drivkin/Autobalance/hardware/Orders/PR_McMaster_Autobalancer_DR.xlsx

Sheet: PR
Purchase Request
 | ALL FIELDS are required to be filled in except for shaded areas prior to placing order.
 | Supplier Info |  |  |  |  | Project / Task # |  | Other |  |  | Category Codes: | Unit Size Codes: | Project/Task # | WBS | Order Method | Deliver To | Ship to Address
 |  |  |  |  |  | Other (Comments) |  | G-NAT T&I Labs |  |  | 39 | BX | MDD | 1-Project Mgmt | Phone/POC | Andrea Nazzal | NASA Ames Bld 202 Room 108 Moffett Field, CA 94035-1000
 | Name | McMaster Carr |  |  |  | WBS |  |  |  |  | 51 | CNT | MisST | 2-System Engineering | Web | Michael Henchke | NASA Ames Bld 240 Room 161 Moffett Field, CA 94035-1000
 | Contact |  |  |  |  | Requester Name |  | Dayne Kemp |  |  | 53 | CRT | EcAMSAT | 3-Safety and Mission Assurance | Email
 | Phone | 562-692-5911 |  |  |  | Phone # |  | (650) 604-4259 |  |  | 59 | CS | SporeSat | 4-Science and Technology | Fax
 | Address |  |  |  |  | Date Orignated |  | 2015-08-23 |  |  | 61 | DZ | NLAS | 5-Payload
 |  |  |  |  |  | Date Required |  | 2015-08-26 |  |  | 66 | EA | SPHERES | 6-Spacecraft
 | E-mail |  |  |  |  | Deliver To |  | Andrea Nazzal |  |  | 68 | FT | PhoneSat 1 | 7-Mission Ops
 | Web Link | www.mcmaster.com |  |  |  | Ship To Address |  | NASA Ames Bld 202 Room 108 Moffett Field, CA 94035-1000 |  |  | 75 | LOT | PhoneSat 2 | 8-Launch
 |  |  |  |  |  |  |  |  |  |  | 76 | OZA | WinkLink | 9-Ground Ops
 | Order Method | Web |  |  |  |  |  |  |  |  | 93 | PAK | UV-LED | 10-Integration and Test
 | Quote Number: | Web |  |  |  |  |  |  |  |  | 99 | RL | Lightforce | 11-EPO
 | Due Diligence (list of other Vendors Contacted): |  |  |  |  |  |  |  |  |  | 7020 | RM | OCT | Other
 |  |  |  |  |  |  |  |  |  |  | 7045 | RO | Franklin
 |  |  |  |  |  |  |  |  |  |  | J | SH | Edison
 |  |  |  | Please check where applicable |  |  |  |  |  |  | V1 | TU | TechEdSat
 |  |  |  | ____ | Material Safety Data Sheet |  |  |  |  |  |  |  | GraviSat
 |  |  |  | ____ | Certificate of Conformance |  |  |  |  |  |  |  | Proposals
 |  |  |  |  |  |  |  |  |  |  |  |  | MoonExpress
 | Category Codes: |  |  |  |  |  |  |  | Unit Size Codes: |  |  |  | EtherSat
 | 39 = Materials Handling Equipment |  |  | 75 = Office Supplies and Devices |  |  |  |  | BX = Box | OZA = Fluid Oz |  |  | SkyBox
 | 51 = Hand Tools |  |  | 76 = Books |  |  |  |  | CNT = Container | PAK = Pack |  |  | Ride the Light
 | 53 = Hardware & Adhesives |  |  | 93 = Nonmetallic Fabricated Materials |  |  |  |  | CRT = Carton | RL = Reel |  |  | NanoLab
 | 59 = Electronic Equipment & Components |  |  | 99 = Miscellaneous |  |  |  |  | CS = CASE | RM = Ream |  |  | Lab Upgrades
 | 61 = Electric Wire, Power & Distribution Equipment |  |  | J = Maintenance, Repair and Rebuilding of Equipment |  |  |  |  | DZ = Dozen | RO = Roll |  |  | Other
 | 66 = Instruments and Laboratory Equipment |  |  | V1=Transportation of Things |  |  |  |  | EA = Each | SH = Sheet
 | 7020= IT Purchases Gov't |  |  |  |  |  |  |  | FT = Feet | TU = Tube
 | 7045 = IT Supplies & Materials |  |  |  |  |  |  |  | LOT= Lot
 | Part Number |  | Item Description |  |  | Category | Unit Size | Quantity | Est. Price | Est. Extended Price
1 | 90322A657 (http://www.mcmaster.com/) |  | Grade 8 Steel Fully Threaded Rod, 1/4"-20 Thread, 2 Feet Long |  |  | 53 | EA | 2 | $6.93 | $13.86
2 | 94612A101 (http://www.mcmaster.com/) |  | Zinc Plated Grade 8 Steel Flange Nut, 1/4"-20 Thread Size, 19/32" Flange Diameter, 15/64" Overall Height , packs of 100 |  |  | 53 | BX | 1 | 7.48 | $7.48
3 | 90272A115 (http://www.mcmaster.com/) |  | Zinc-Plated Steel Pan Head Phillips Machine Screw, 4-40 Thread, 1" Length, packs of 100 |  |  | 53 | BX | 1 | $3.00 | $3.00
4 | 90272A121 (http://www.mcmaster.com/) |  | Zinc-Plated Steel Pan Head Phillips Machine Screw, 4-40 Thread, 2" Length, packs of 50 |  |  | 53 | BX | 1 | $6.30 | $6.30
5 | 90257A005 (http://www.mcmaster.com/) |  | Type 316 Stainless Steel Hex Nut, 4-40 Thread Size, 1/4" Wide, 3/32" High, packs of 100 |  |  | 53 | BX | 1 | $5.91 | $5.91
6 | 4416T91 (http://www.mcmaster.com/) |  | Very Easy-to-Machine 1215 Carbon Steel, Rod, 3/16" Diameter, 6' Length |  |  | 53 | EA | 1 | $5.89 | $5.89
7 |  |  |  |  |  |  |  |  |  | $0.00
8 |  |  |  |  |  |  |  |  |  | $0.00
9 |  |  |  |  |  |  |  |  |  | $0.00
10 |  |  |  |  |  |  |  |  |  | $0.00
11 |  |  |  |  |  |  |  |  |  | $0.00
12 |  |  |  |  |  |  |  |  |  | $0.00
13 |  |  |  |  |  |  |  |  |  | $0.00
14 |  |  |  |  |  |  |  |  |  | $0.00
15 |  |  |  |  |  |  |  |  |  | $0.00
16 |  |  |  |  |  |  |  |  |  | $0.00
17 |  |  |  |  |  |  |  |  |  | $0.00
18 |  |  |  |  |  |  |  |  |  | $0.00
19 |  |  |  |  |  |  |  |  |  | $0.00
20 |  |  |  |  |  |  |  |  |  | $0.00
 |  |  |  |  |  |  |  |  | Subtotal | $42.44
 |  | Dayne Kemp |  |  |  |  |  |  | Ship & Hand. | $15.00
 |  | Requester Signature |  |  |  |  |  |  | TAX | $15.80
 |  |  |  |  |  |  |  |  | Est. Total | $73.24
 |  | Authorizing Signature: Project Mangr or Task Lead

Sheet: Process
New NMO PR Process:
1- Individual generates PR (Save document
2- PR is submitted to WBS Lead or Project Manager (if no lead is assigned) for approval
3- Lead sends directly to Andrea Nazzal AND cc’s:
a. Elwood Agasid
b. PR Originator
c. Mike Henschke (SSPT only)
4- Andrea Nazzal verifies funding and sends to Dionna Marshall to place order
5- Dionna Marshall places order and sends email notification of when the package is expected to arrive to:
a. Lead who submitted the PR
b. PR Originator
c. Mike Henschke (SSPT only)
6- Mike Henschke (SSPT) or Dionna Marshall (MDD) will notify when the product has arrived
7- All original shipping documentation (invoices and packaging slips) MUST be turned into Dionna Marshall ASAP
PR Originator is responsible for the following:
1- Making sure PR is filled completely and accurately
2- Knowing lead times associated with the order and notating on PR
3- Noting back ordered items when possible
4- Not designating ASAP, provide hard date
5- Be cognicent of overnight shipping it REALLY eats away at your budget
Program or Project Leads
EcAMSat (MoO1) | Karolyn Ronzano
Ethersat | Belgacem Jaroux
Gravisat | Tony Ricco
Lightforce | Belgacem Jaroux/ Creon Levit
MDD | Belgacem Jaroux
MisST | Andres Martinez
NanoLab (ISSRP) | Macarena Parra/Andres Martinez
NLAS | Andres Martinez
Phonesat | Belgacem Jaroux
Spheres | Andres Martinez
Sporesat (MoO2) | Ron Chinnapongse
UVLED | John Hanson/Belgacem Jaroux
