drivkin/Autobalance/hardware/Orders/McMasterJuly13.xlsx

Description | McMaster Part number | Quantity | Notes
Angle Brackets | 1556A26 | 10
Shoulder screws 4-40, 1/8” shoulder | 91259A154 | 25
Ball bearing | 6383K213 (http://www.mcmaster.com/) |  | talk to machinist about putting in ¼ threaded lead screw
3/8” rod | 89535K87 (http://www.mcmaster.com/) | 6ft
Brass bars (1x2x6)” |  | 1 | not ordered
flanged sleeve bearings | 9440T17 | 12
