drivkin/Autobalance/hardware/Orders/first order.xlsx

Part | Manufacturer | Quantity | part number | other param | quote | Contact
Lead screw | Helix Linear | 3 |  | 1/4" diameter, .024" lead, 1 foot length | about $180 total screws and nuts | Keith Bell, +1 216 485-2309, kbell@helixlinear.com
Anti-backlash nut | Helix Linear | 3 | AFA025024R | high force spring, flanged |  | ditto
Stepper Motor | Lin Engineering | 3 | 3709Z-12 | Mounting option 4 | 63.81 each | Monica in customer service, 408-919-0200
