drivkin/Autobalance/CAD/first time mockup/whole_assembly.SLDASM

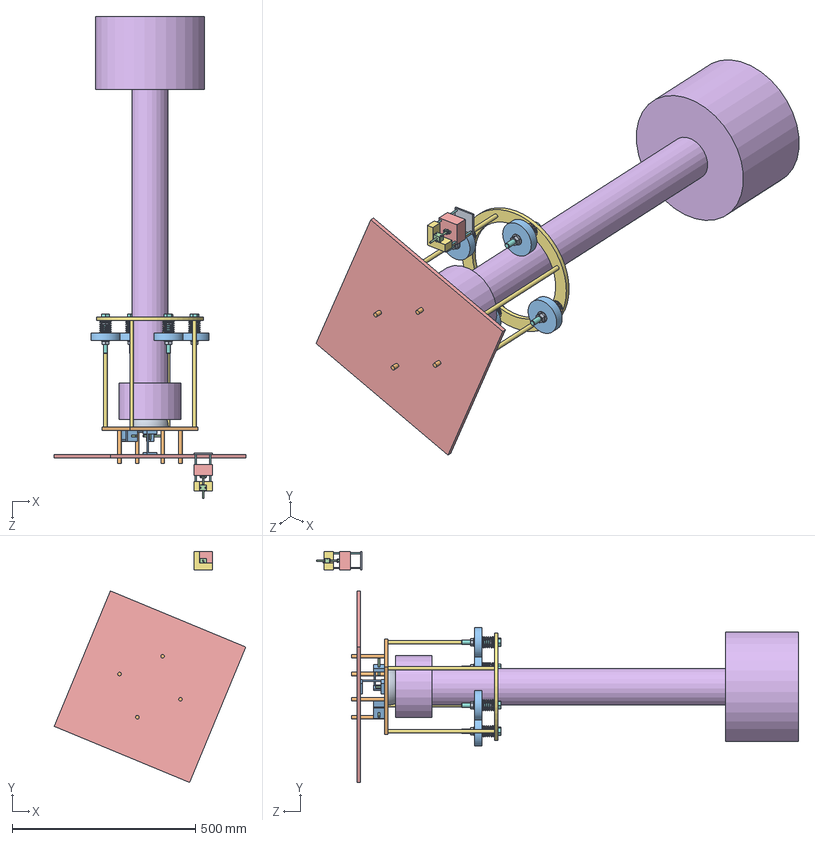
[picture p8: CAD file, 2015-06-24]
CAD/first time mockup/whole_assembly.SLDASM
522.7 x 630.1 x 1315.9 mm
bearing
balance_base
motor_body x 3
motor_shaft x 3
testbed
pedestal
manual_balance_rim
B18.2.3.6M - Heavy hex bolt M12 x 1.75 x 100 --100C x 4
B18.2.2.4M - Hex flange nut, M12 x 1.75 --N x 8
spring x 4
BIGweight x 4
N-422_50
weight
B18.6.7M - M2 x 0.4 x 20 Indented HHMS --20C x 4
base
supportRod x 2
endPiece
