drivkin/Autobalance/CAD/force sensor calibrator/side.SLDPRT

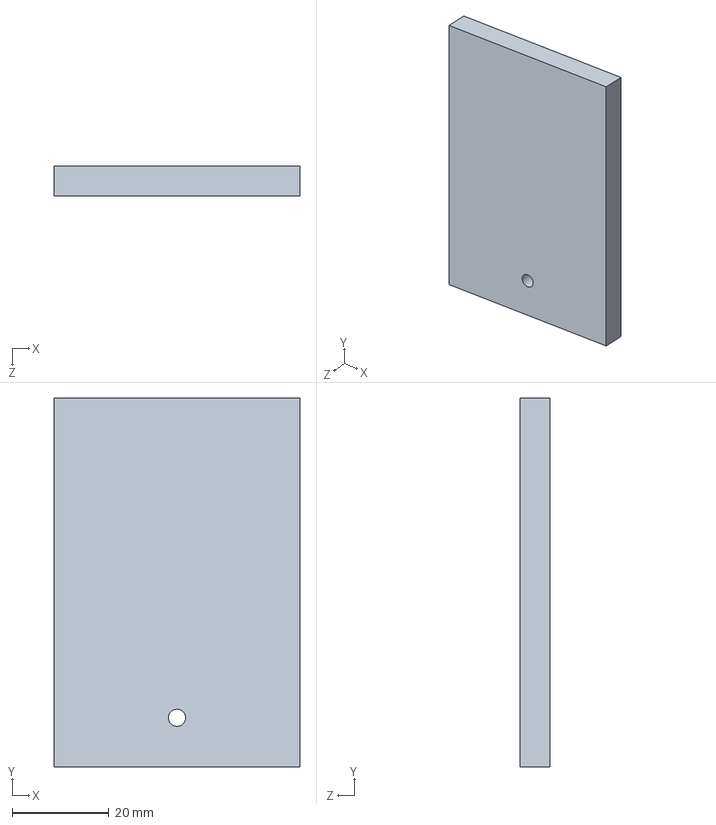
[picture p9: CAD file, 2015-09-15]
CAD/force sensor calibrator/side.SLDPRT
50.8 x 76.2 x 6.10 mm
