drivkin/Autobalance/CAD/TestBed Alternate/level.SLDPRT

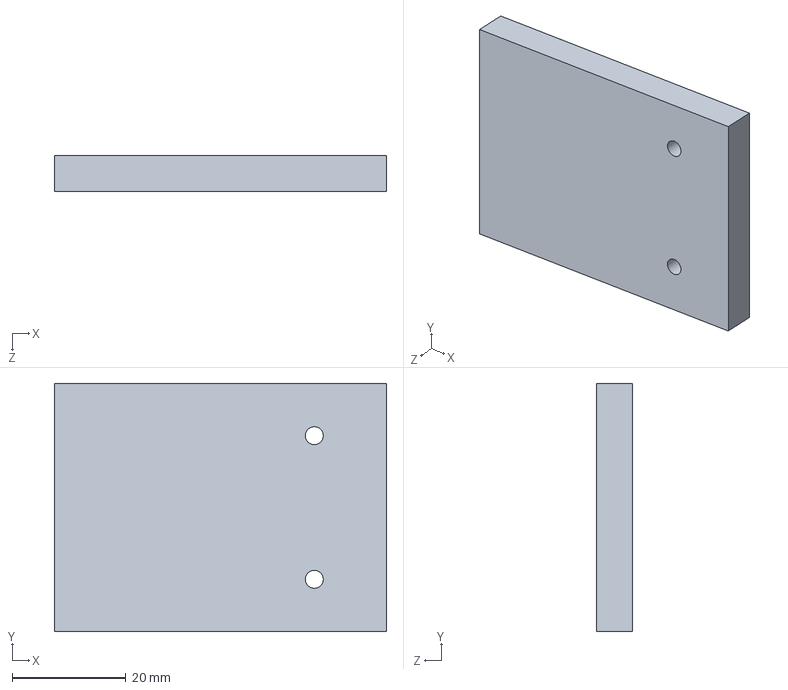
[picture p10: CAD file, 2015-09-15]
CAD/TestBed Alternate/level.SLDPRT
58.4 x 43.7 x 6.35 mm
