drivkin/Autobalance/CAD/TestBed/ABpedestal.SLDPRT

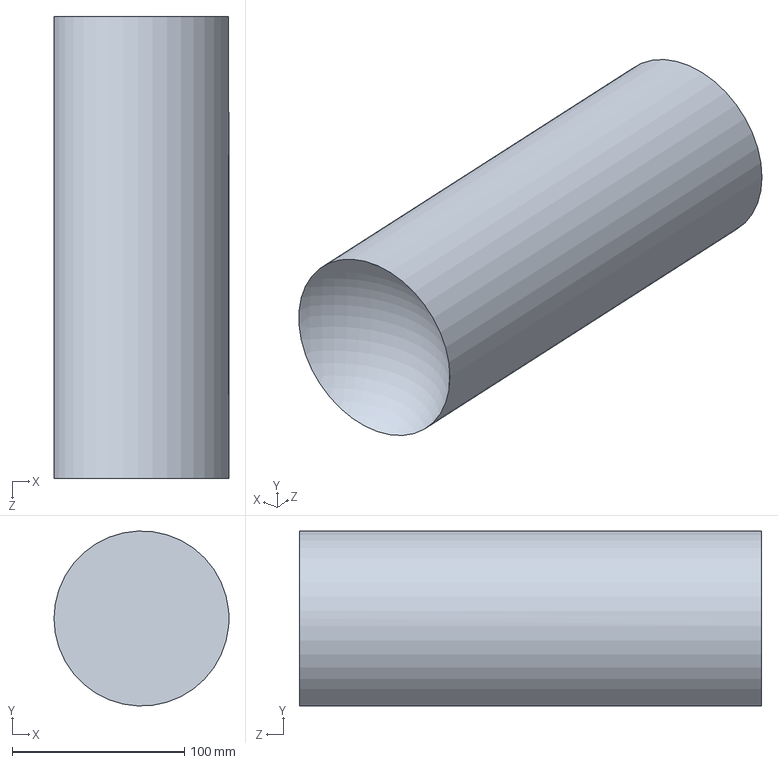
[picture p11: CAD file, 2015-07-17]
CAD/TestBed/ABpedestal.SLDPRT
101.6 x 101.5 x 268.4 mm
