drivkin/Autobalance/CAD/first time mockup/driver.SLDPRT

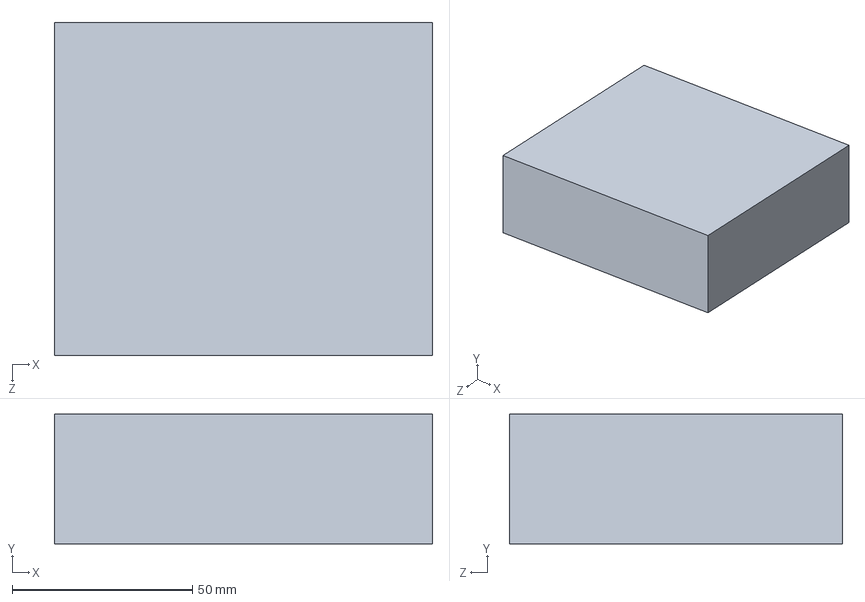
[picture p12: CAD file, 2015-06-24]
CAD/first time mockup/driver.SLDPRT
105.0 x 36.0 x 92.5 mm
