drivkin/Autobalance/CAD/FSR/lip_support.SLDPRT

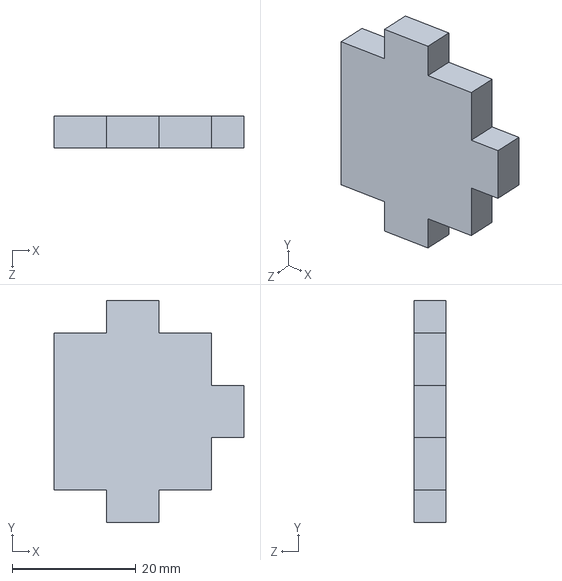
[picture p13: CAD file, 2015-09-15]
CAD/FSR/lip_support.SLDPRT
30.6 x 35.8 x 5.21 mm
