drivkin/Autobalance/CAD/N-422_50 assembly/weight.SLDPRT

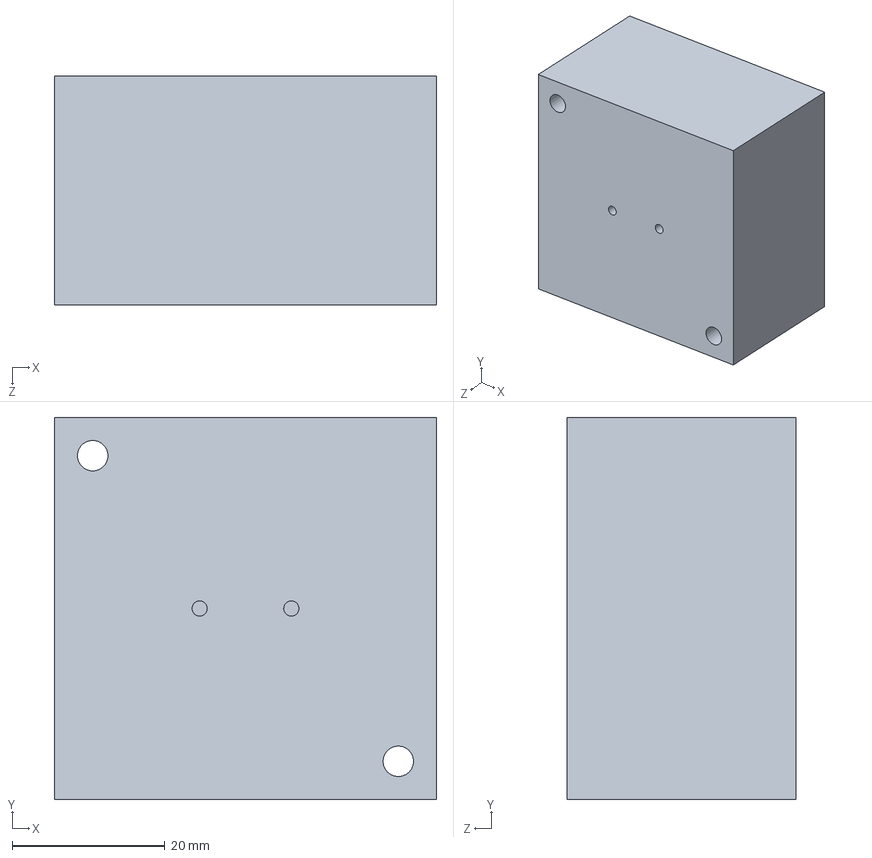
[picture p14: CAD file, 2015-07-06]
CAD/N-422_50 assembly/weight.SLDPRT
50.0 x 50.0 x 30.0 mm
