drivkin/Autobalance/CAD/TestBed Alternate/alt_AD_Testbed_Top.SLDPRT

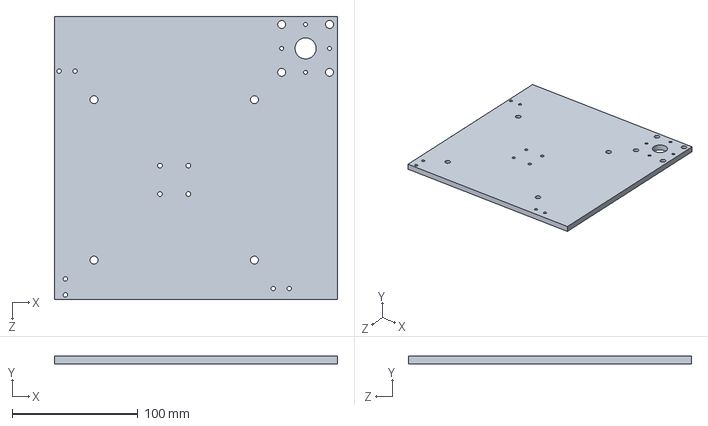
[picture p15: CAD file, 2015-09-15]
CAD/TestBed Alternate/alt_AD_Testbed_Top.SLDPRT
225.2 x 6.35 x 225.2 mm
