drivkin/Autobalance/CAD/force sensor calibrator/arm.SLDPRT

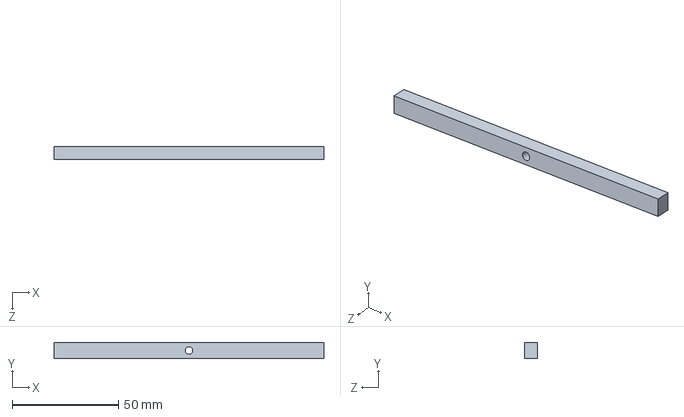
[picture p16: CAD file, 2015-09-15]
CAD/force sensor calibrator/arm.SLDPRT
127.0 x 7.62 x 6.10 mm
