drivkin/Autobalance/CAD/FSR/vert_slider_lip.SLDPRT

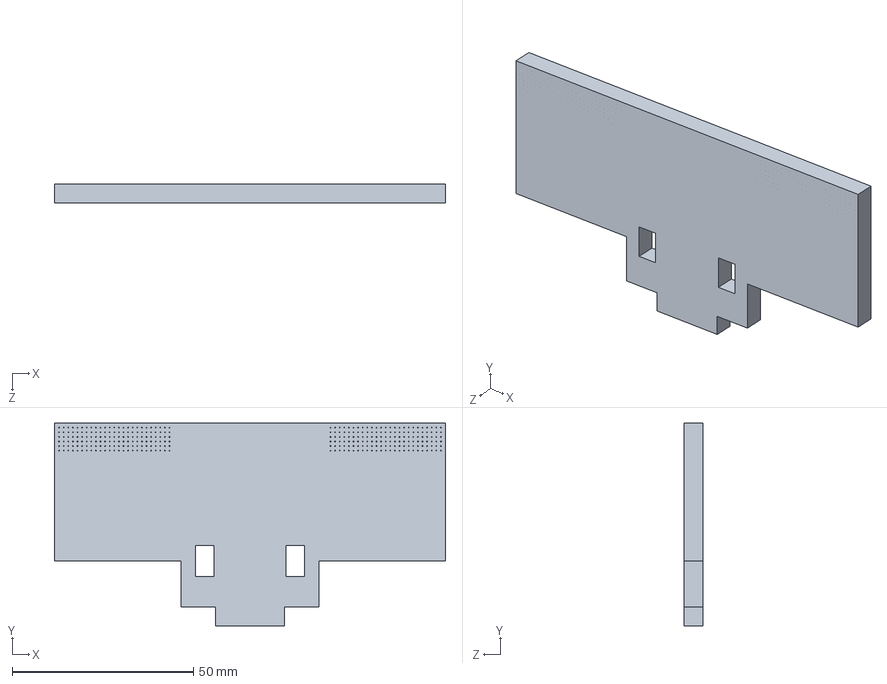
[picture p17: CAD file, 2015-09-15]
CAD/FSR/vert_slider_lip.SLDPRT
108.0 x 56.0 x 5.21 mm
