drivkin/Autobalance/CAD/N-422_50 assembly/base.SLDPRT

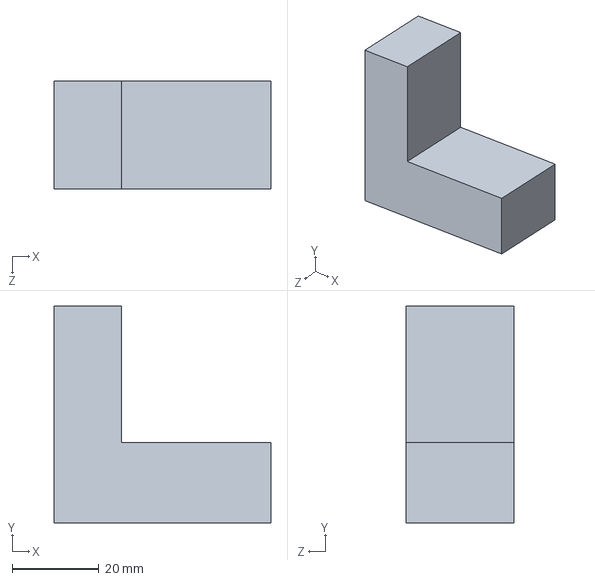
[picture p18: CAD file, 2015-06-24]
CAD/N-422_50 assembly/base.SLDPRT
50.0 x 50.0 x 25.0 mm
