drivkin/Autobalance/CAD/TestBed Alternate/alt_basement.SLDPRT

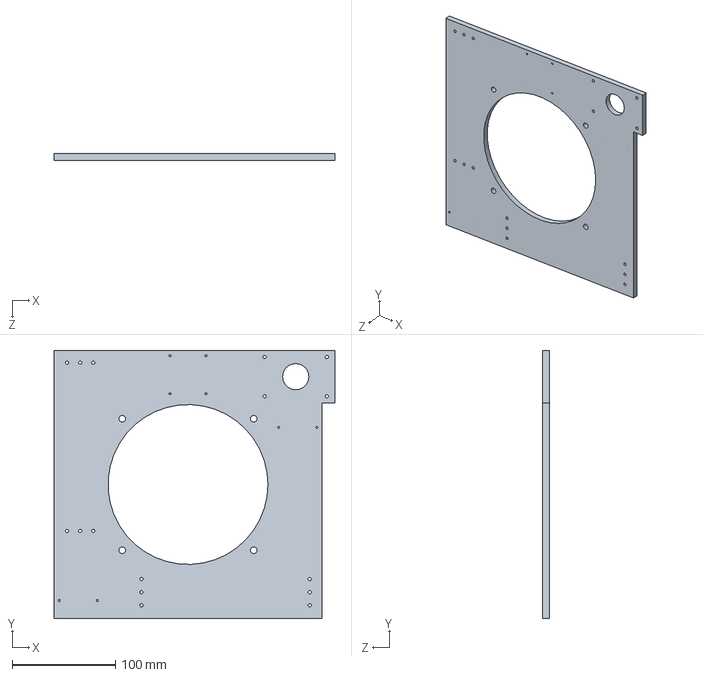
[picture p19: CAD file, 2015-09-15]
CAD/TestBed Alternate/alt_basement.SLDPRT
272.7 x 260.1 x 6.35 mm
