drivkin/Autobalance/CAD/TestBed/ABsphere.SLDPRT

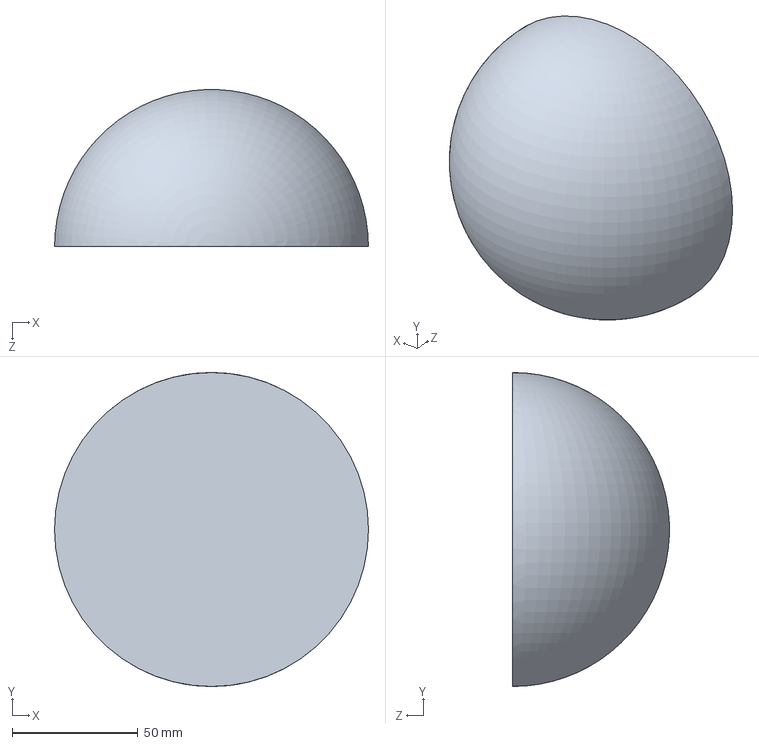
[picture p20: CAD file, 2015-07-17]
CAD/TestBed/ABsphere.SLDPRT
125.0 x 125.0 x 62.4 mm
