drivkin/Autobalance/CAD/first time mockup/BIGweight.SLDPRT

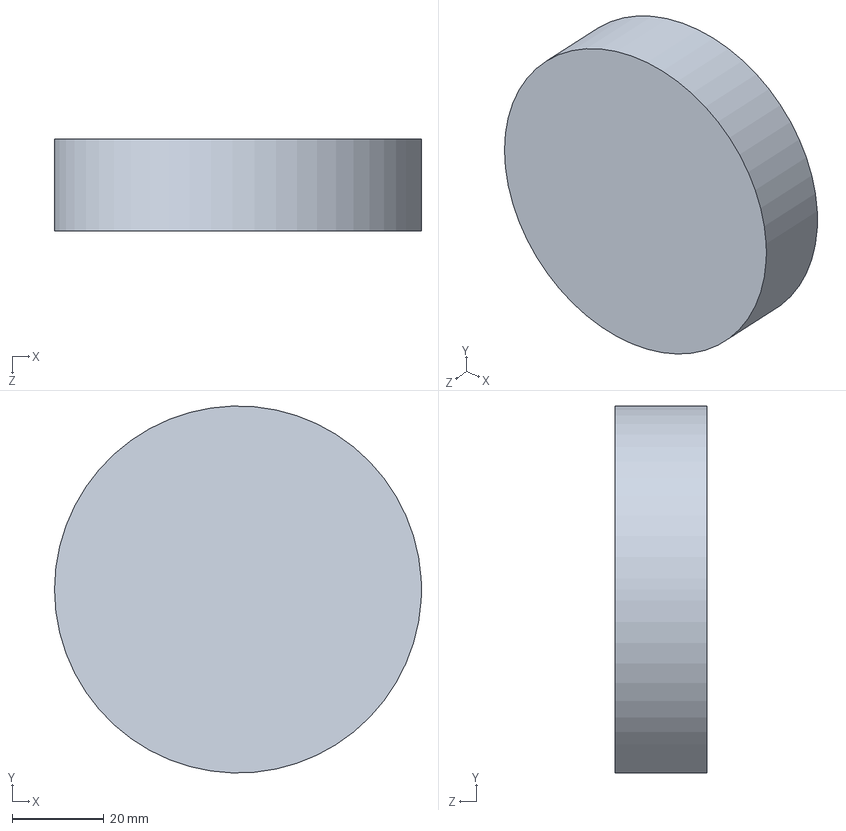
[picture p21: CAD file, 2015-06-18]
CAD/first time mockup/BIGweight.SLDPRT
80.0 x 80.0 x 20.0 mm
