drivkin/Autobalance/CAD/force sensor calibrator/connector.SLDPRT

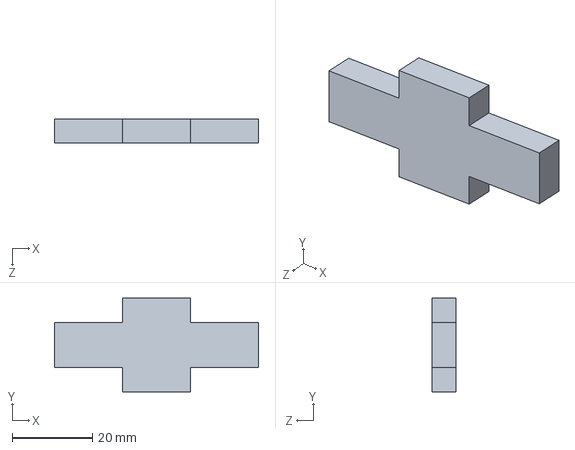
[picture p22: CAD file, 2015-09-15]
CAD/force sensor calibrator/connector.SLDPRT
50.8 x 23.4 x 6.10 mm
