drivkin/Autobalance/CAD/FSR/vert_slider.SLDPRT

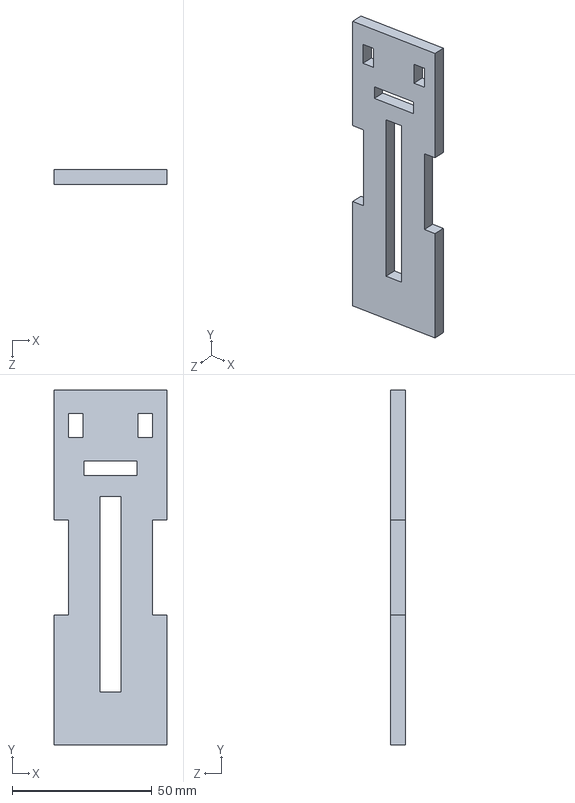
[picture p23: CAD file, 2015-09-15]
CAD/FSR/vert_slider.SLDPRT
40.4 x 127.0 x 5.21 mm
