drivkin/Autobalance/CAD/N-422_50 assembly/endPiece.SLDPRT

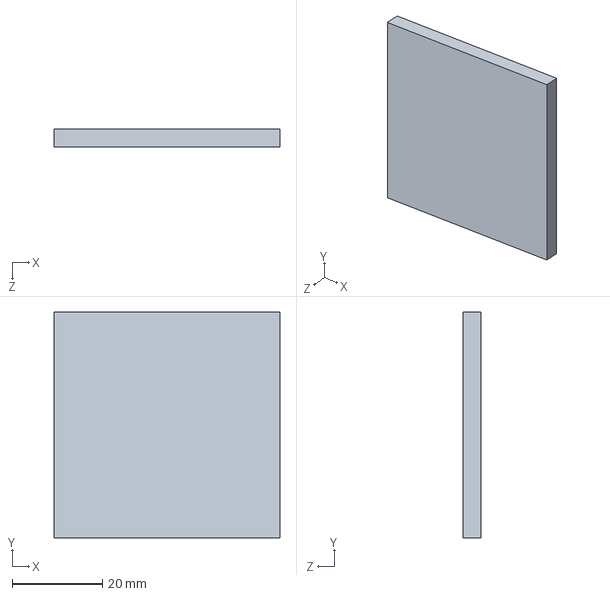
[picture p24: CAD file, 2015-06-24]
CAD/N-422_50 assembly/endPiece.SLDPRT
50.0 x 50.0 x 4.00 mm
