drivkin/Autobalance/CAD/TestBed/AD_Testbed_Bottom_LEDholes.SLDPRT

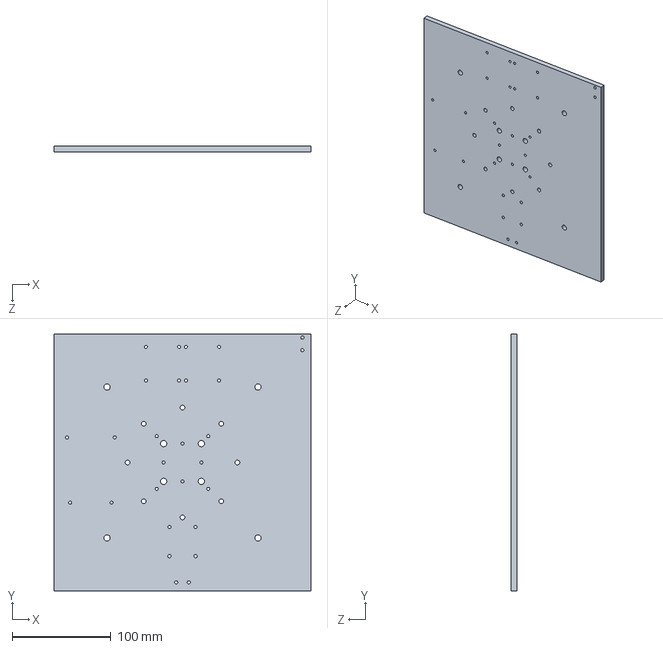
[picture p26: CAD file, 2015-07-17]
CAD/TestBed/AD_Testbed_Bottom_LEDholes.SLDPRT
260.0 x 260.0 x 6.35 mm
