drivkin/Autobalance/CAD/first time mockup/B18.2.2.4M - Hex flange nut, M12 x 1.75 --N.SLDPRT

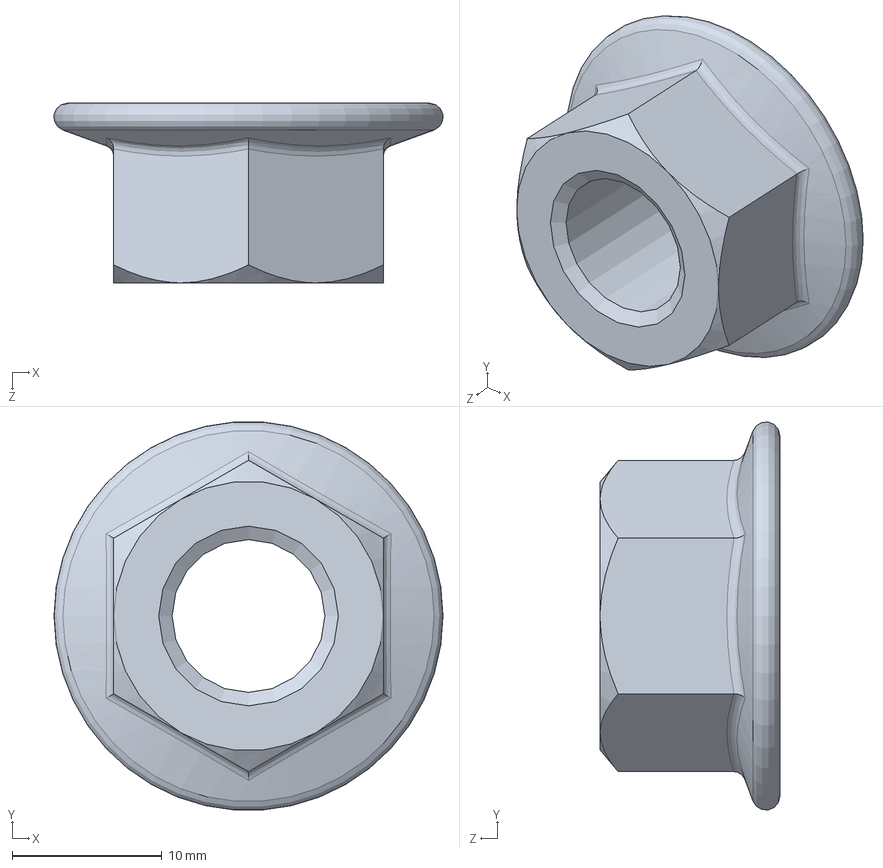
[picture p27: CAD file, 2015-06-18]
CAD/first time mockup/B18.2.2.4M - Hex flange nut, M12 x 1.75 --N.SLDPRT
26.0 x 25.9 x 12.0 mm
