drivkin/Autobalance/CAD/FSR/vert_slider_side.SLDPRT

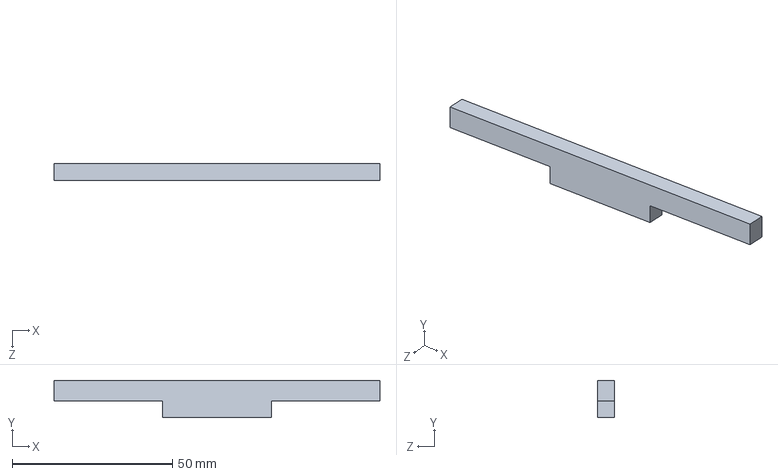
[picture p28: CAD file, 2015-09-15]
CAD/FSR/vert_slider_side.SLDPRT
101.6 x 11.6 x 5.21 mm
