drivkin/Autobalance/CAD/N-422_50 assembly/N-422_50.SLDPRT

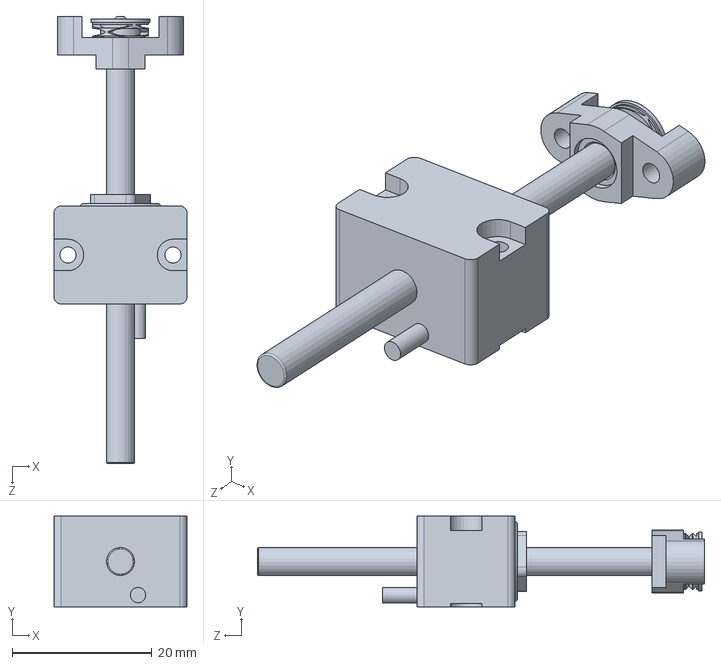
[picture p29: CAD file, 2015-06-24]
CAD/N-422_50 assembly/N-422_50.SLDPRT
19.0 x 13.0 x 63.9 mm
