drivkin/Autobalance/CAD/TestBed/third_floor.SLDPRT

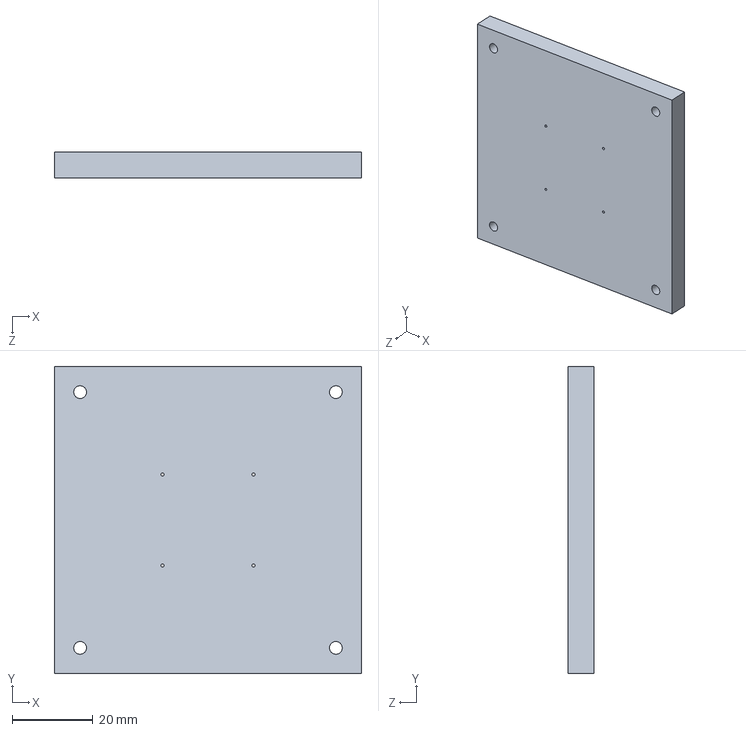
[picture p30: CAD file, 2015-07-16]
CAD/TestBed/third_floor.SLDPRT
76.2 x 76.2 x 6.35 mm
