drivkin/Autobalance/CAD/first time mockup/bearing.SLDPRT

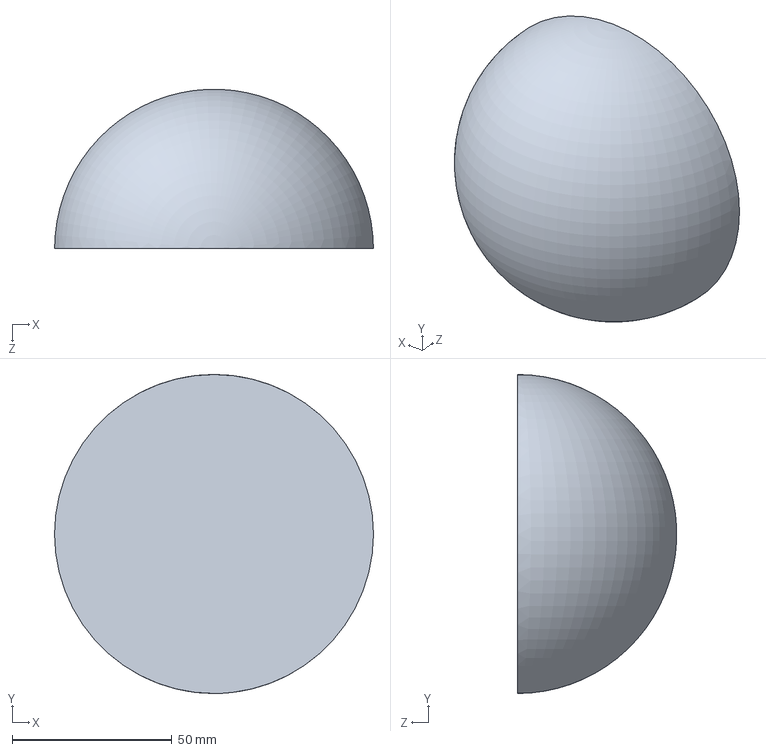
[picture p31: CAD file, 2015-06-18]
CAD/first time mockup/bearing.SLDPRT
100.0 x 100.0 x 49.9 mm
