drivkin/Autobalance/CAD/FSR/vert_slider_base.SLDPRT

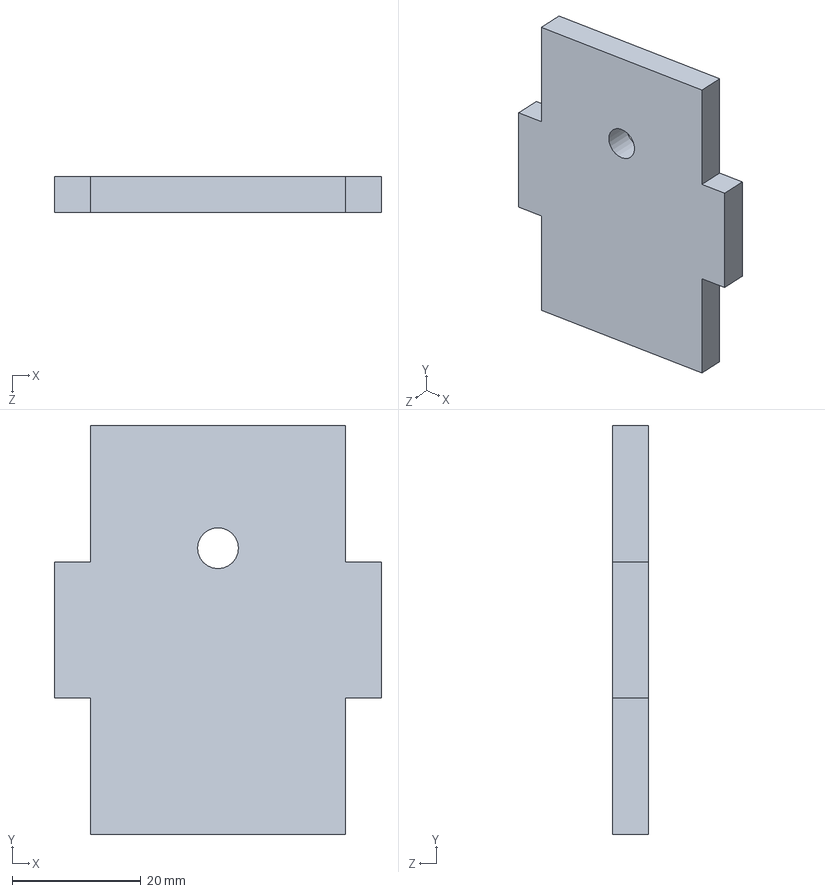
[picture p32: CAD file, 2015-09-15]
CAD/FSR/vert_slider_base.SLDPRT
50.8 x 63.5 x 5.59 mm
