drivkin/Autobalance/CAD/N-422_50 assembly/B18.6.7M - M2 x 0.4 x 20 Indented HHMS --20C.sldprt

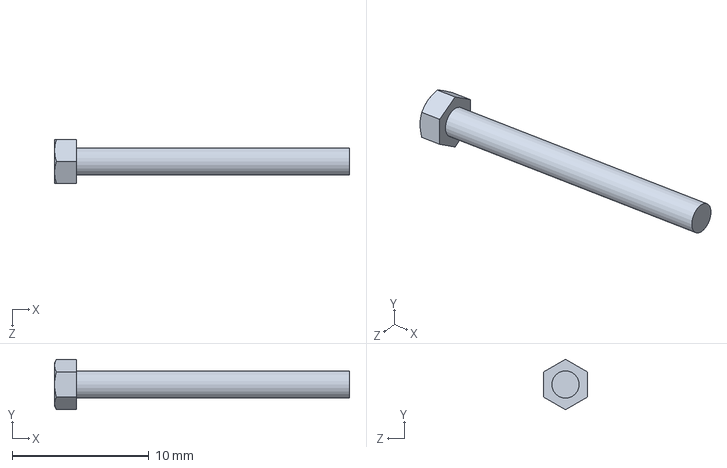
[picture p33: CAD file, 2015-06-24]
CAD/N-422_50 assembly/B18.6.7M - M2 x 0.4 x 20 Indented HHMS --20C.sldprt
21.6 x 3.70 x 3.20 mm
