drivkin/Autobalance/CAD/TestBed Alternate/alt_food_crate_storage.SLDPRT

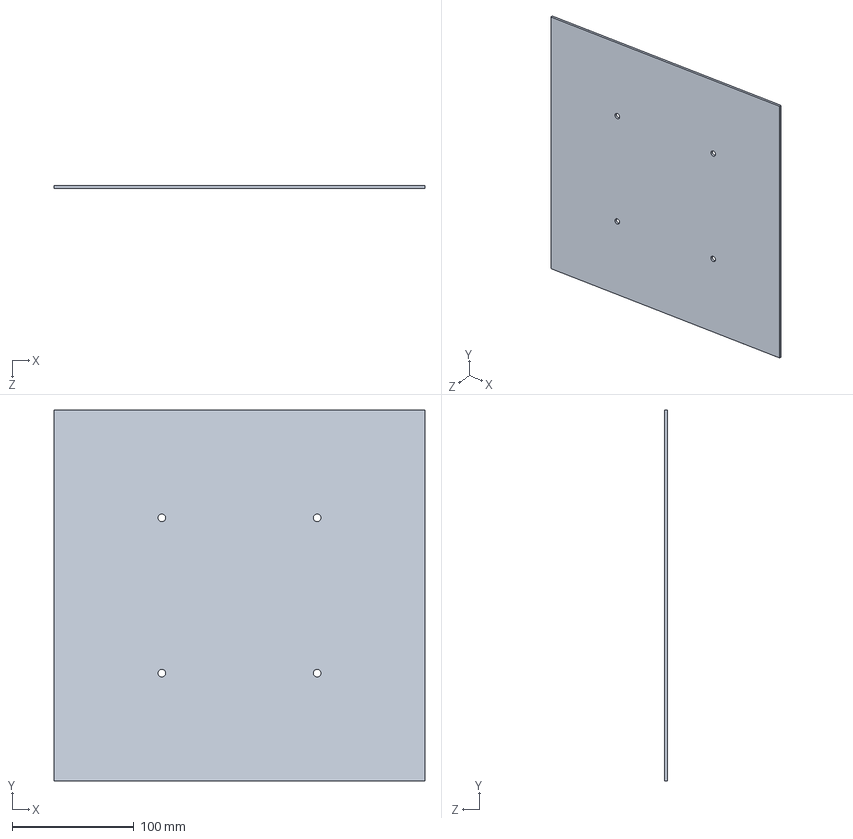
[picture p34: CAD file, 2015-09-15]
CAD/TestBed Alternate/alt_food_crate_storage.SLDPRT
304.8 x 304.8 x 2.54 mm
