drivkin/Autobalance/CAD/TestBed/AD_Testbed_Top.SLDPRT

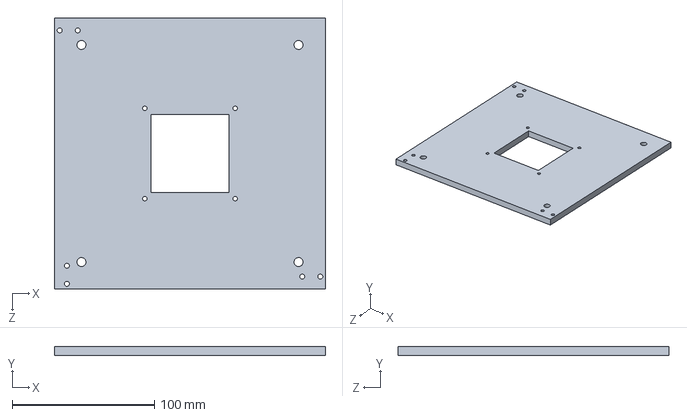
[picture p35: CAD file, 2015-07-16]
CAD/TestBed/AD_Testbed_Top.SLDPRT
190.5 x 6.35 x 190.5 mm
