drivkin/Autobalance/CAD/first time mockup/motor_body.SLDPRT

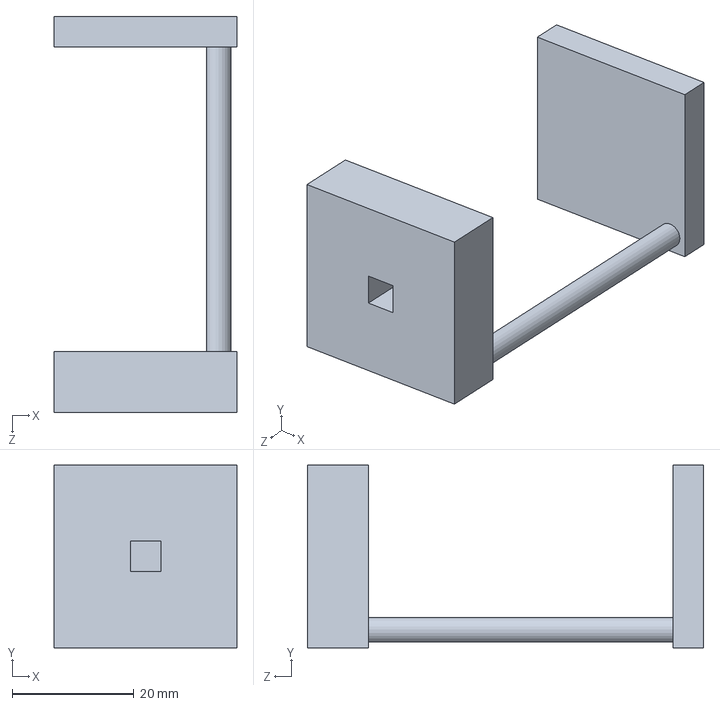
[picture p36: CAD file, 2015-06-18]
CAD/first time mockup/motor_body.SLDPRT
30.0 x 30.0 x 65.0 mm
