drivkin/Autobalance/CAD/N-422_50 assembly/supportRod.SLDPRT

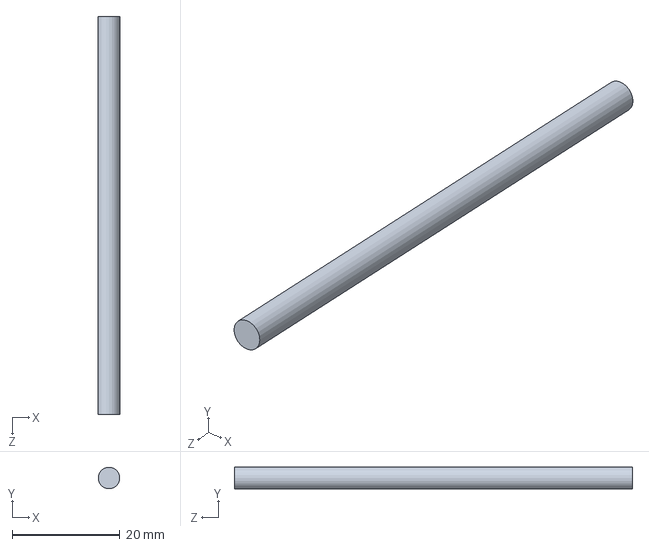
[picture p37: CAD file, 2015-06-24]
CAD/N-422_50 assembly/supportRod.SLDPRT
4.00 x 4.00 x 74.0 mm
