drivkin/Autobalance/CAD/TestBed Alternate/alt_vert_spacer_male.SLDPRT

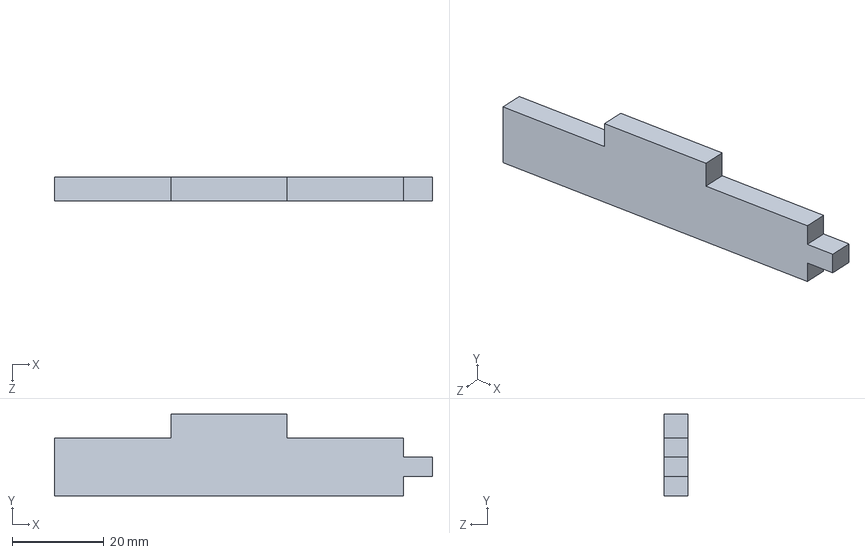
[picture p38: CAD file, 2015-09-15]
CAD/TestBed Alternate/alt_vert_spacer_male.SLDPRT
82.5 x 17.9 x 5.21 mm
