drivkin/Autobalance/CAD/TestBed/bracket.SLDPRT

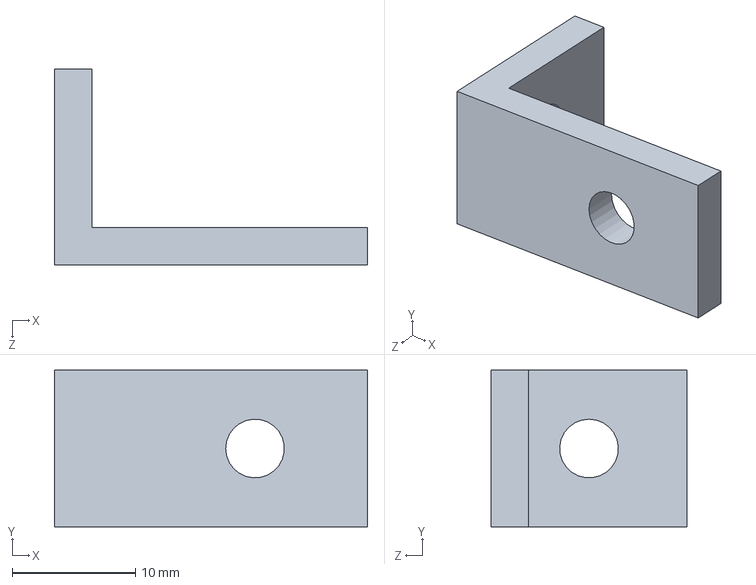
[picture p39: CAD file, 2015-07-15]
CAD/TestBed/bracket.SLDPRT
25.4 x 12.7 x 15.9 mm
