drivkin/Autobalance/CAD/first time mockup/balance_base.SLDPRT

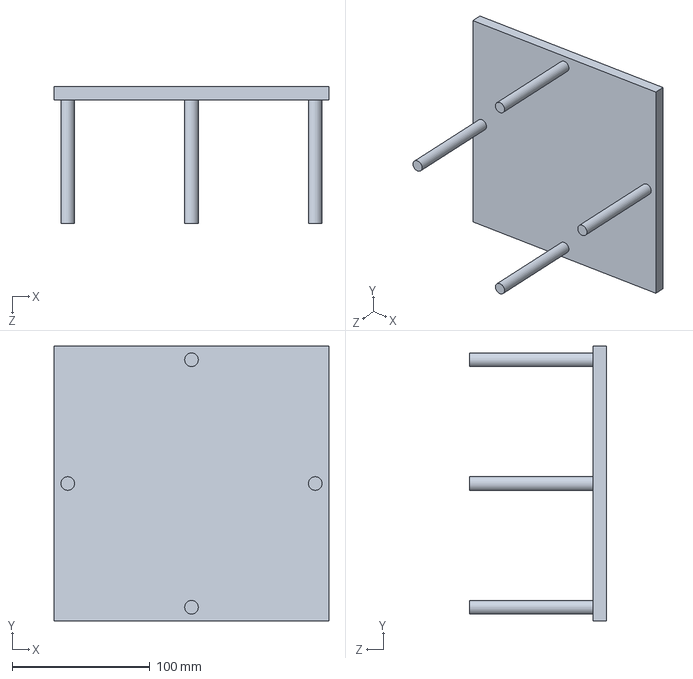
[picture p40: CAD file, 2015-06-18]
CAD/first time mockup/balance_base.SLDPRT
200.0 x 200.0 x 100.0 mm
