drivkin/Autobalance/CAD/FSR/horz_slider_side.SLDPRT

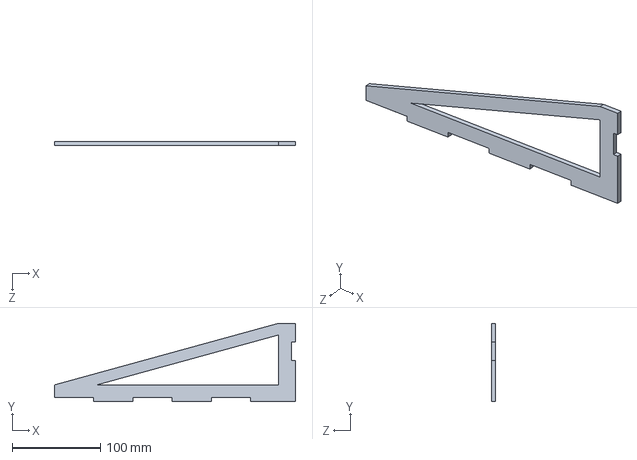
[picture p41: CAD file, 2015-09-15]
CAD/FSR/horz_slider_side.SLDPRT
273.0 x 88.9 x 4.70 mm
