drivkin/Autobalance/CAD/first time mockup/pedestal.SLDPRT

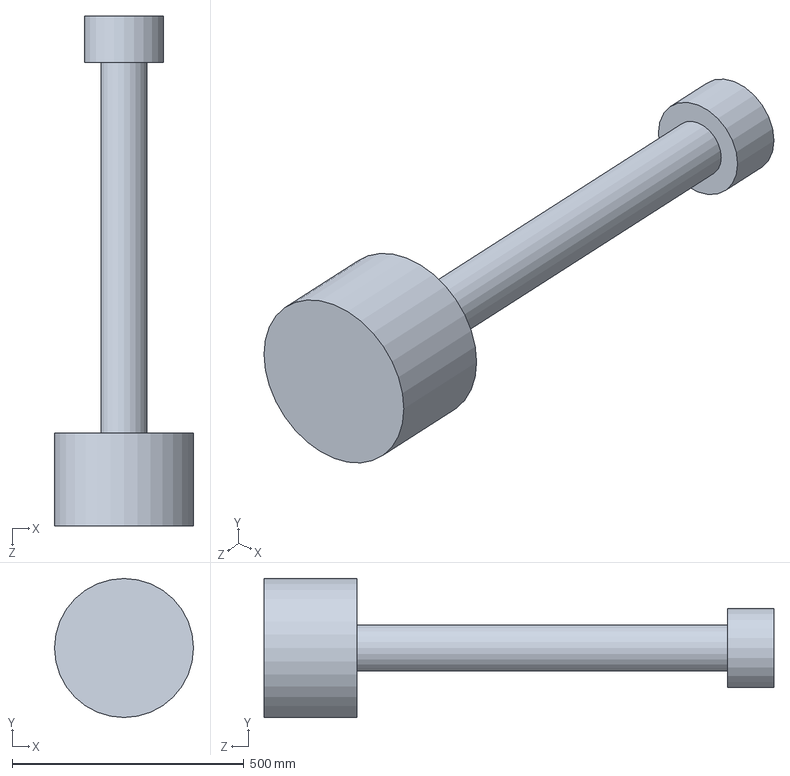
[picture p42: CAD file, 2015-06-18]
CAD/first time mockup/pedestal.SLDPRT
300.0 x 300.0 x 1100.0 mm
