drivkin/Autobalance/CAD/FSR/bottom_lip.SLDPRT

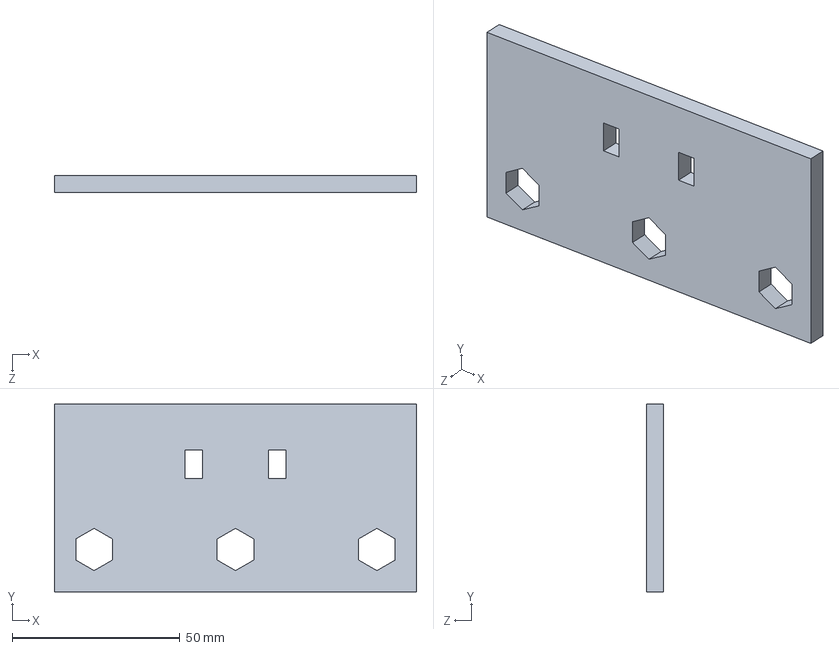
[picture p43: CAD file, 2015-09-15]
CAD/FSR/bottom_lip.SLDPRT
108.0 x 56.0 x 5.21 mm
