drivkin/Autobalance/CAD/TestBed Alternate/alt_baseHorz.SLDPRT

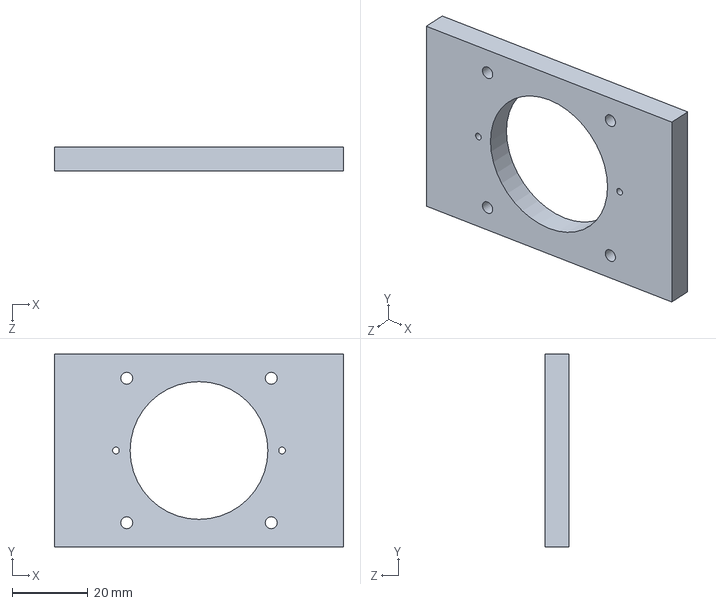
[picture p44: CAD file, 2015-08-26]
CAD/TestBed Alternate/alt_baseHorz.SLDPRT
76.2 x 50.8 x 6.35 mm
