drivkin/Autobalance/CAD/first time mockup/manual_balance_rim.SLDPRT

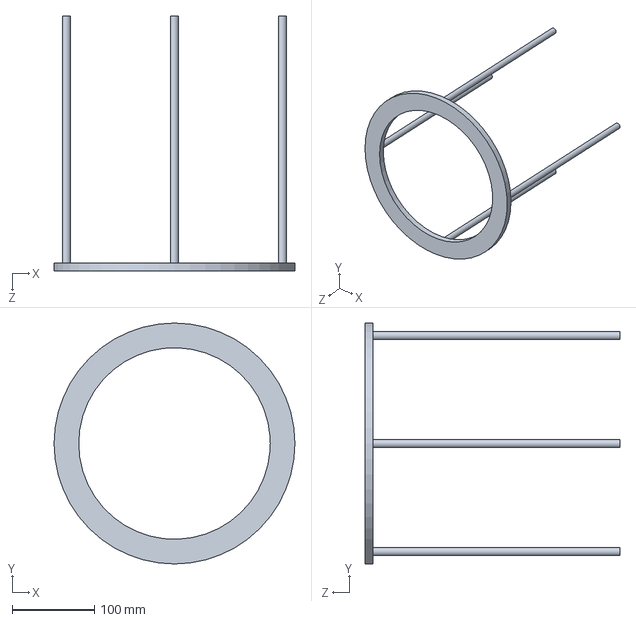
[picture p45: CAD file, 2015-06-18]
CAD/first time mockup/manual_balance_rim.SLDPRT
292.8 x 292.8 x 310.0 mm
