drivkin/Autobalance/CAD/FSR/jaws_bottom.SLDPRT

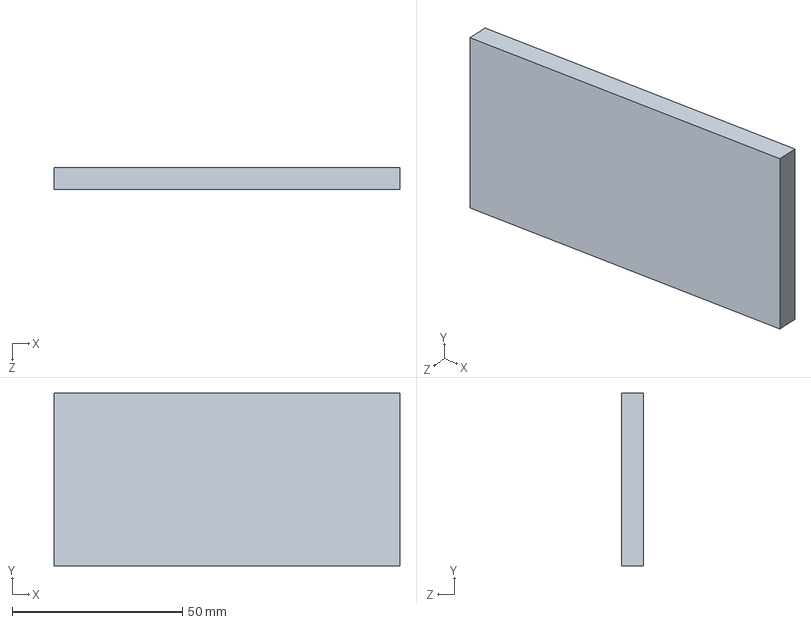
[picture p46: CAD file, 2015-09-15]
CAD/FSR/jaws_bottom.SLDPRT
101.6 x 50.8 x 6.35 mm
