drivkin/Autobalance/CAD/TestBed Alternate/alt_weightLS.SLDPRT

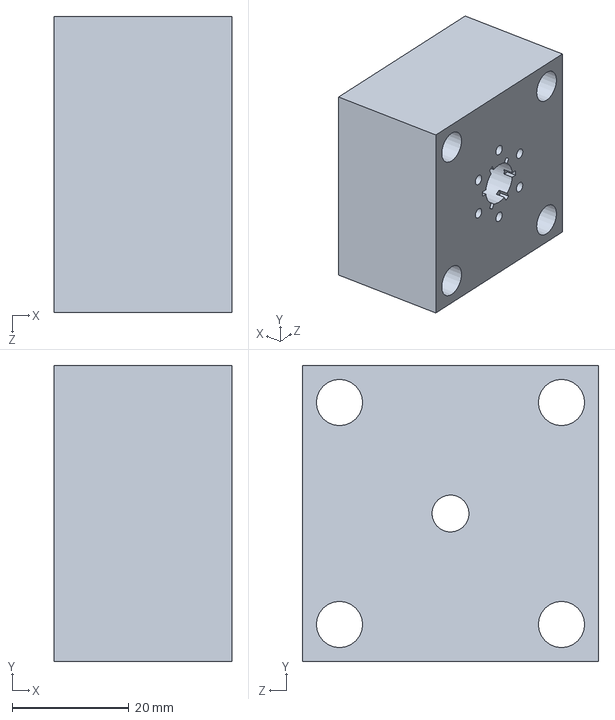
[picture p47: CAD file, 2015-08-26]
CAD/TestBed Alternate/alt_weightLS.SLDPRT
30.5 x 50.8 x 50.8 mm
