drivkin/Autobalance/CAD/first time mockup/weight.SLDPRT

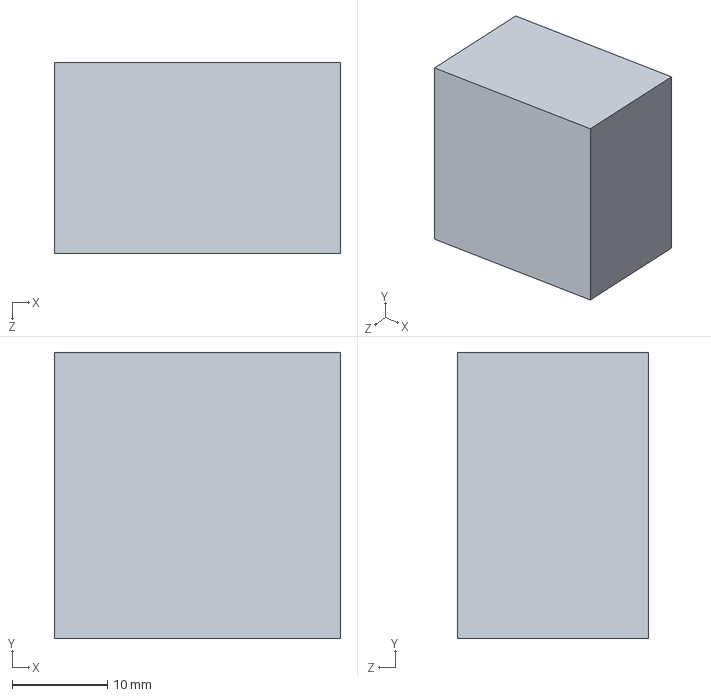
[picture p48: CAD file, 2015-06-18]
CAD/first time mockup/weight.SLDPRT
30.0 x 30.0 x 20.0 mm
