drivkin/Autobalance/CAD/FSR/jaws_back.SLDPRT

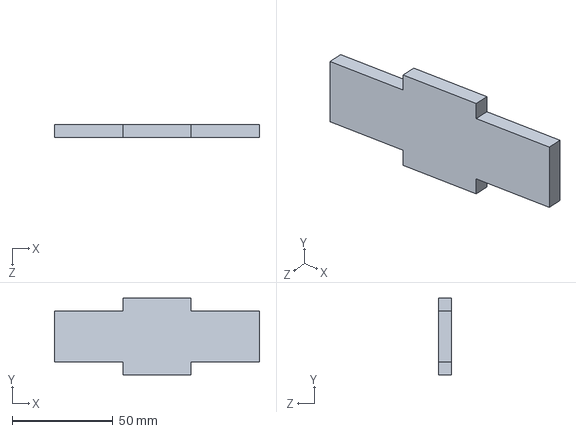
[picture p49: CAD file, 2015-09-15]
CAD/FSR/jaws_back.SLDPRT
101.6 x 38.1 x 6.35 mm
