drivkin/Autobalance/CAD/TestBed Alternate/alt_mini_breadboard.SLDPRT

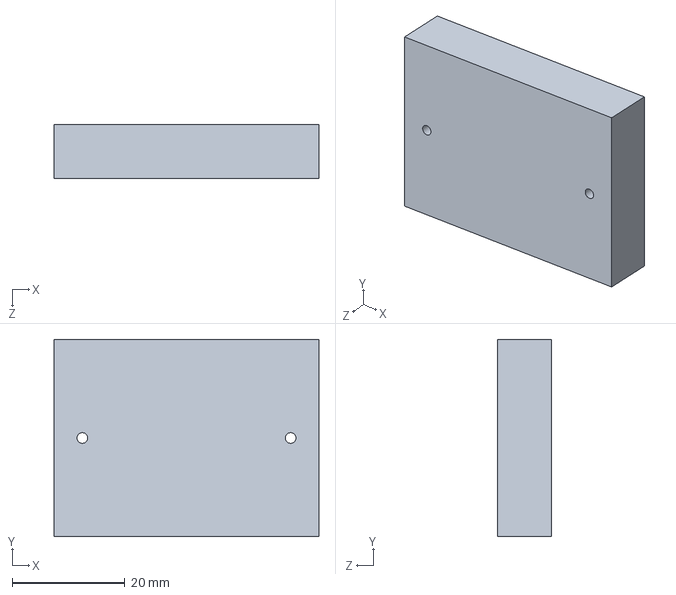
[picture p50: CAD file, 2015-08-26]
CAD/TestBed Alternate/alt_mini_breadboard.SLDPRT
47.1 x 35.0 x 9.53 mm
