drivkin/Autobalance/CAD/first time mockup/testbed.SLDPRT

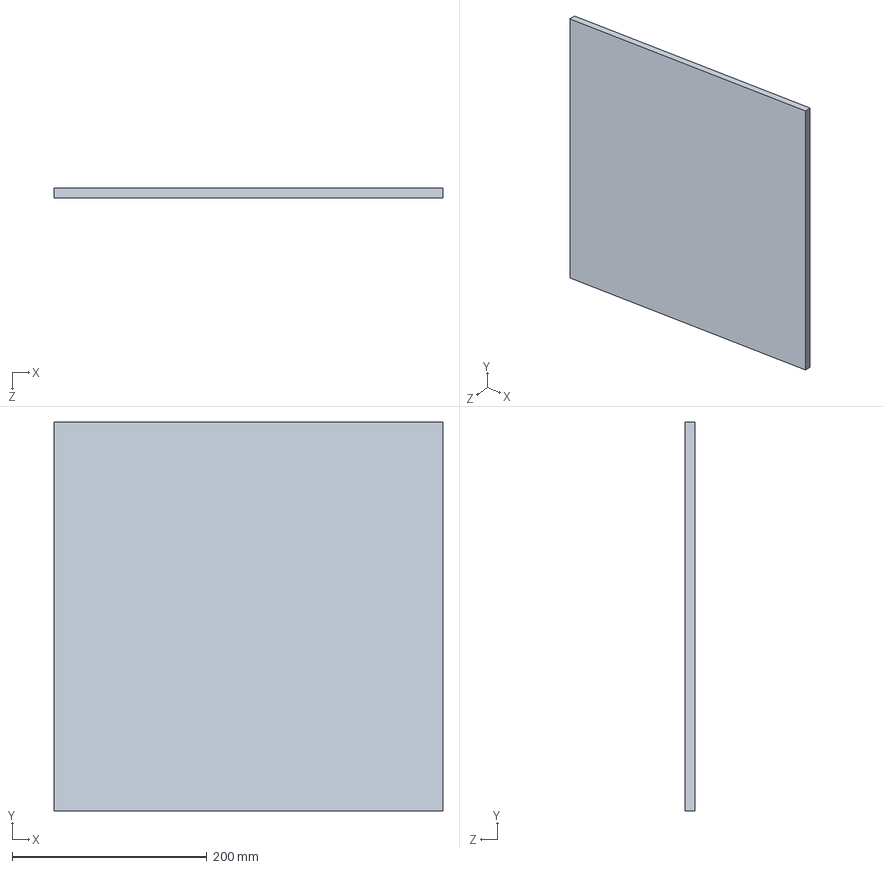
[picture p51: CAD file, 2015-06-18]
CAD/first time mockup/testbed.SLDPRT
400.0 x 400.0 x 10.0 mm
