drivkin/Autobalance/CAD/first time mockup/motor_shaft.SLDPRT

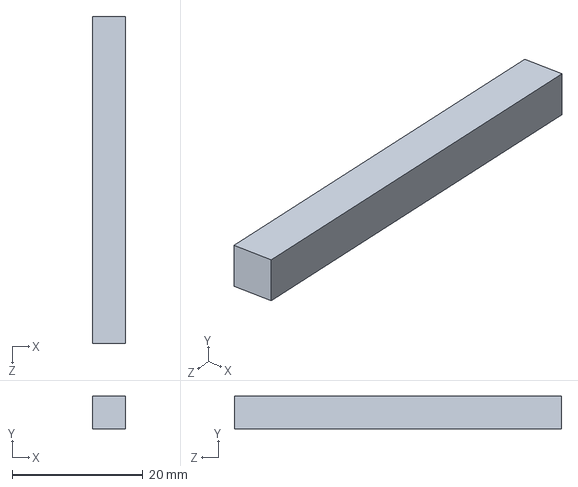
[picture p53: CAD file, 2015-06-18]
CAD/first time mockup/motor_shaft.SLDPRT
5.00 x 5.00 x 50.0 mm
