drivkin/Autobalance/CAD/FSR/jaws_cheek.SLDPRT

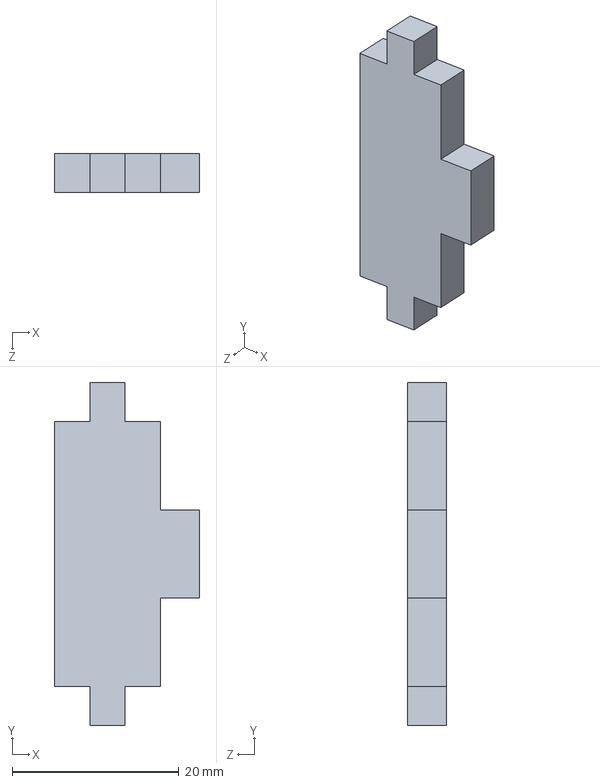
[picture p54: CAD file, 2015-09-15]
CAD/FSR/jaws_cheek.SLDPRT
17.4 x 41.1 x 4.70 mm
