drivkin/Autobalance/CAD/TestBed Alternate/alt_heavyweight.SLDPRT

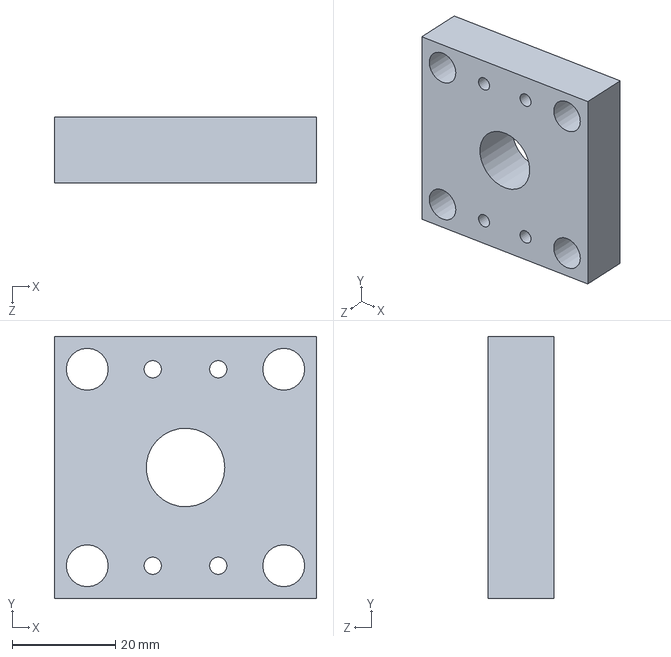
[picture p55: CAD file, 2015-08-19]
CAD/TestBed Alternate/alt_heavyweight.SLDPRT
50.8 x 50.8 x 12.7 mm
