drivkin/Autobalance/CAD/FSR/jaws_top.SLDPRT

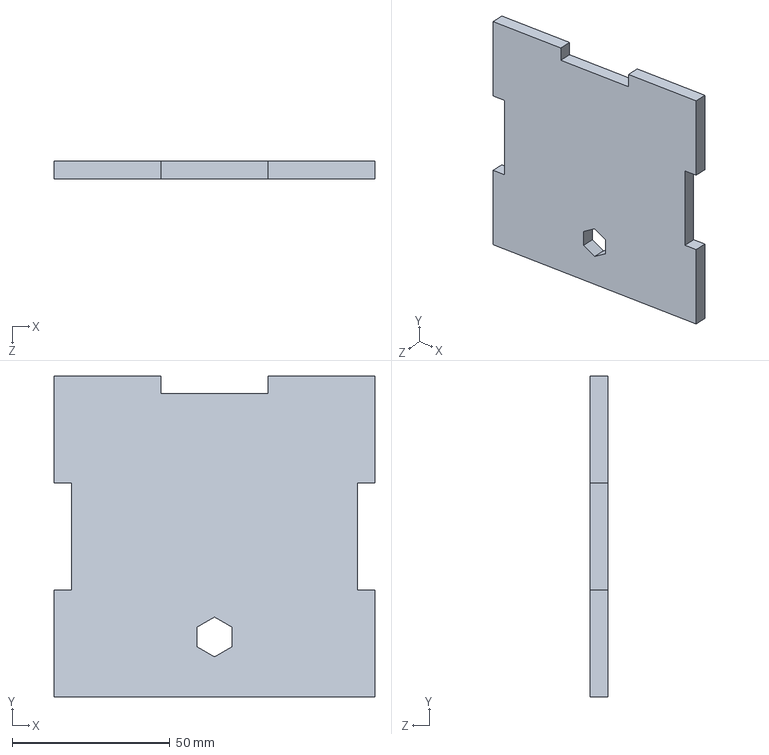
[picture p56: CAD file, 2015-09-15]
CAD/FSR/jaws_top.SLDPRT
101.6 x 101.6 x 5.59 mm
