drivkin/Autobalance/CAD/TestBed Alternate/alt_weightLS_zaxis.SLDPRT

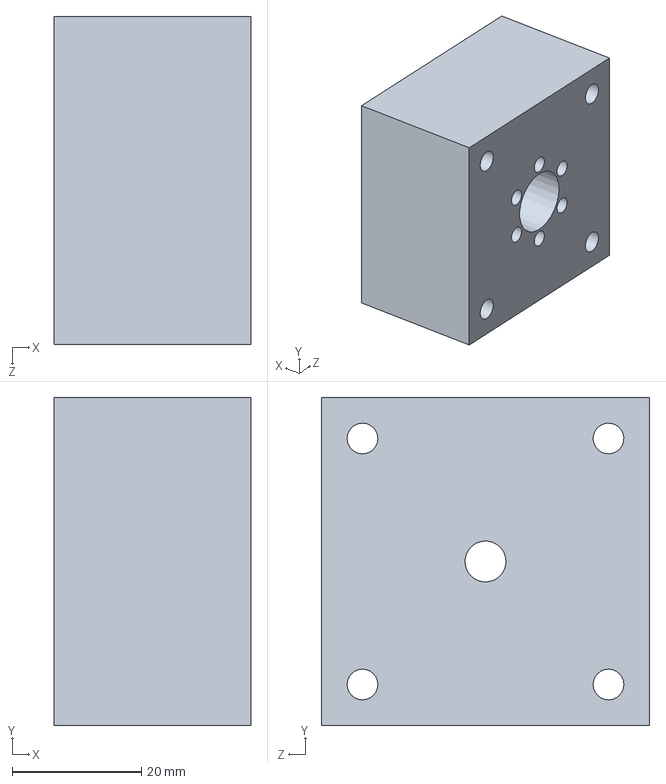
[picture p57: CAD file, 2015-07-29]
CAD/TestBed Alternate/alt_weightLS_zaxis.SLDPRT
30.5 x 50.8 x 50.8 mm
