drivkin/Autobalance/CAD/first time mockup/spring.SLDPRT

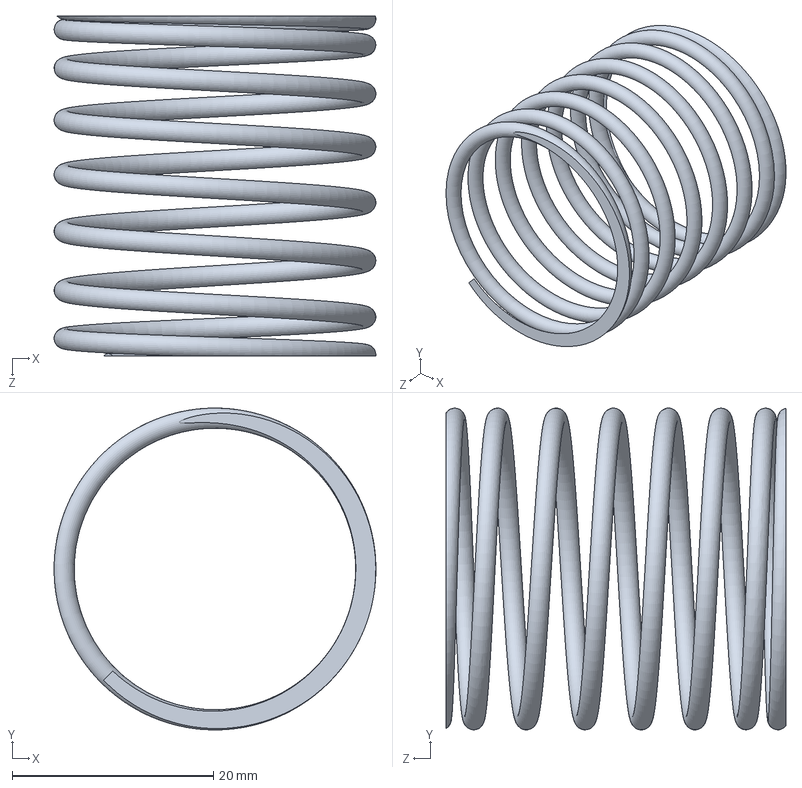
[picture p58: CAD file, 2015-06-18]
CAD/first time mockup/spring.SLDPRT
32.0 x 32.0 x 33.8 mm
