drivkin/Autobalance/CAD/FSR/horz_slider.SLDPRT

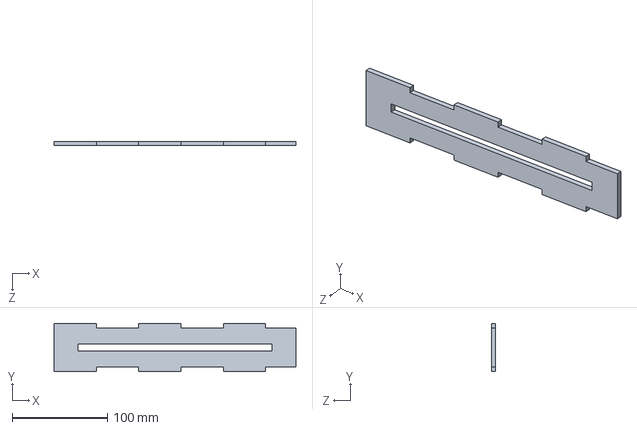
[picture p59: CAD file, 2015-09-15]
CAD/FSR/horz_slider.SLDPRT
254.0 x 50.8 x 4.70 mm
