drivkin/Autobalance/CAD/TestBed Alternate/alt_Lbracket_horz.SLDPRT

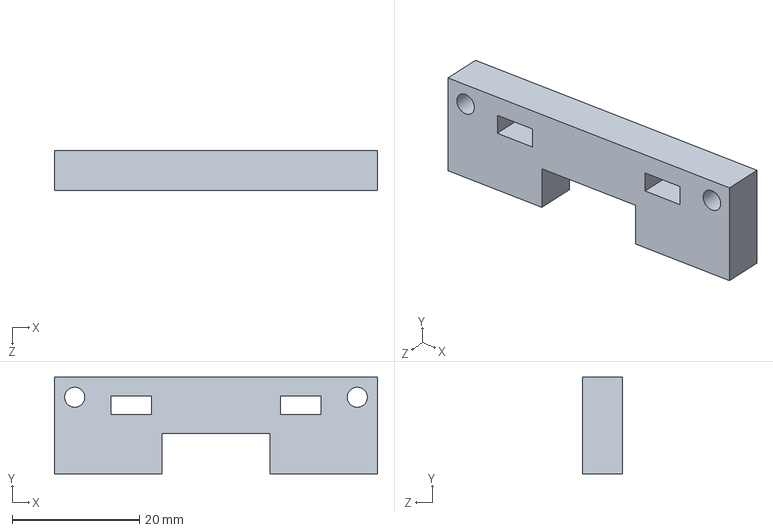
[picture p60: CAD file, 2015-07-29]
CAD/TestBed Alternate/alt_Lbracket_horz.SLDPRT
50.8 x 15.2 x 6.35 mm
