drivkin/Autobalance/CAD/TestBed Alternate/alt_LE 3709z mounting option 8_zaxis.SLDPRT

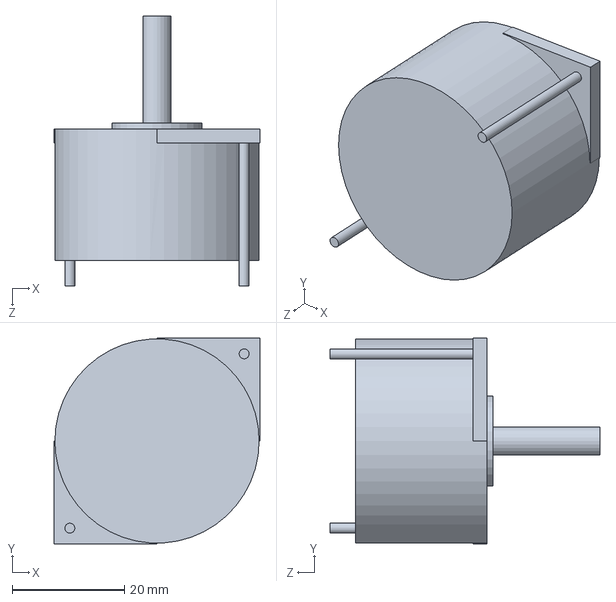
[picture p61: CAD file, 2015-07-29]
CAD/TestBed Alternate/alt_LE 3709z mounting option 8_zaxis.SLDPRT
36.6 x 36.6 x 48.0 mm
