drivkin/Autobalance/CAD/TestBed Alternate/alt_baseHorz_zaxis.SLDPRT

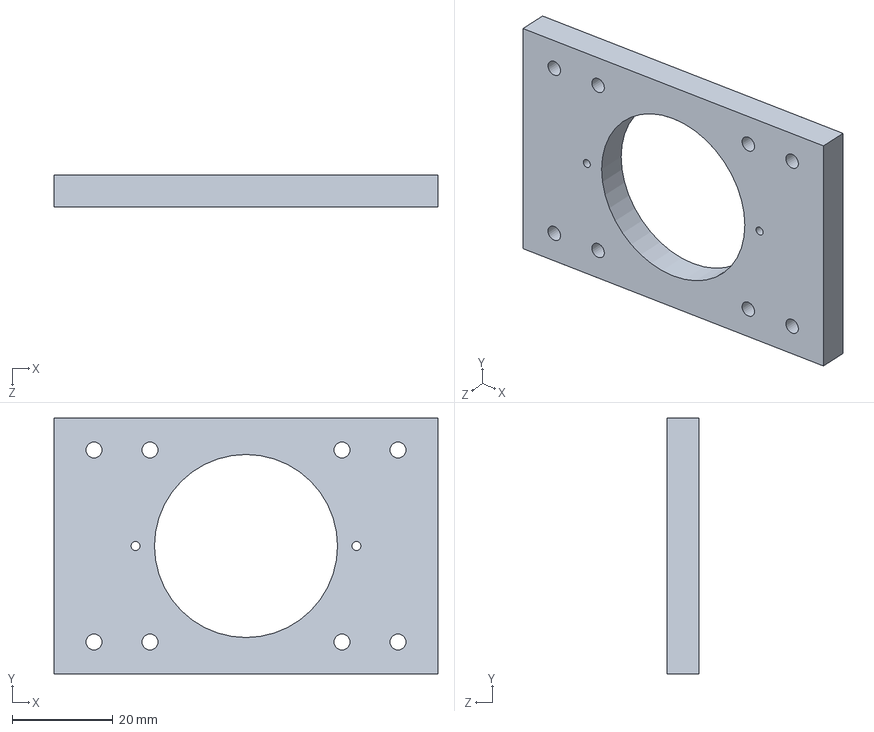
[picture p62: CAD file, 2015-07-29]
CAD/TestBed Alternate/alt_baseHorz_zaxis.SLDPRT
76.2 x 50.8 x 6.35 mm
