drivkin/Autobalance/CAD/TestBed Alternate/alt_weightLS_acrylic.SLDPRT

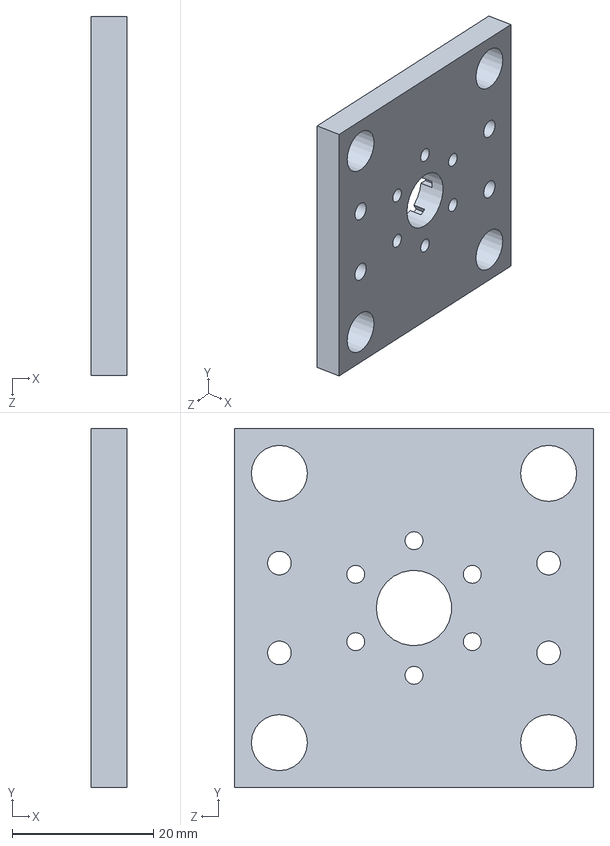
[picture p63: CAD file, 2015-07-29]
CAD/TestBed Alternate/alt_weightLS_acrylic.SLDPRT
5.08 x 50.8 x 50.8 mm
