drivkin/Autobalance/CAD/TestBed Alternate/alt_supportLS_zaxis.SLDPRT

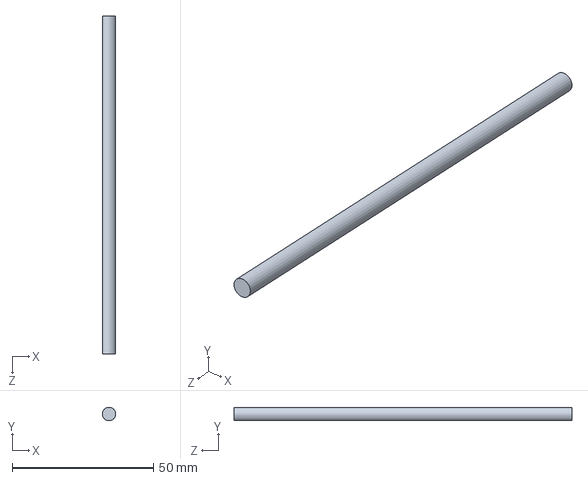
[picture p64: CAD file, 2015-07-29]
CAD/TestBed Alternate/alt_supportLS_zaxis.SLDPRT
4.76 x 4.76 x 119.7 mm
