drivkin/Autobalance/CAD/TestBed Alternate/alt_endpieceLS_zaxis.SLDPRT

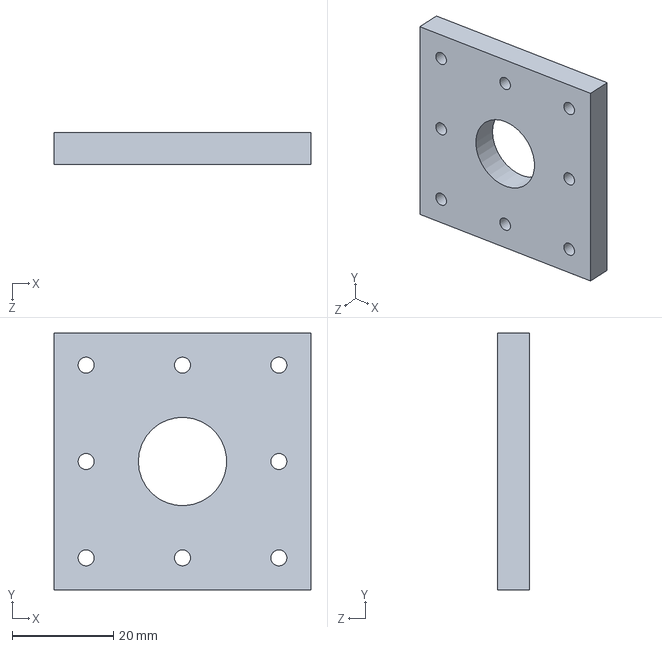
[picture p65: CAD file, 2015-07-29]
CAD/TestBed Alternate/alt_endpieceLS_zaxis.SLDPRT
50.8 x 50.8 x 6.35 mm
