drivkin/Autobalance/CAD/TestBed Alternate/alt_Lbracket_support.SLDPRT

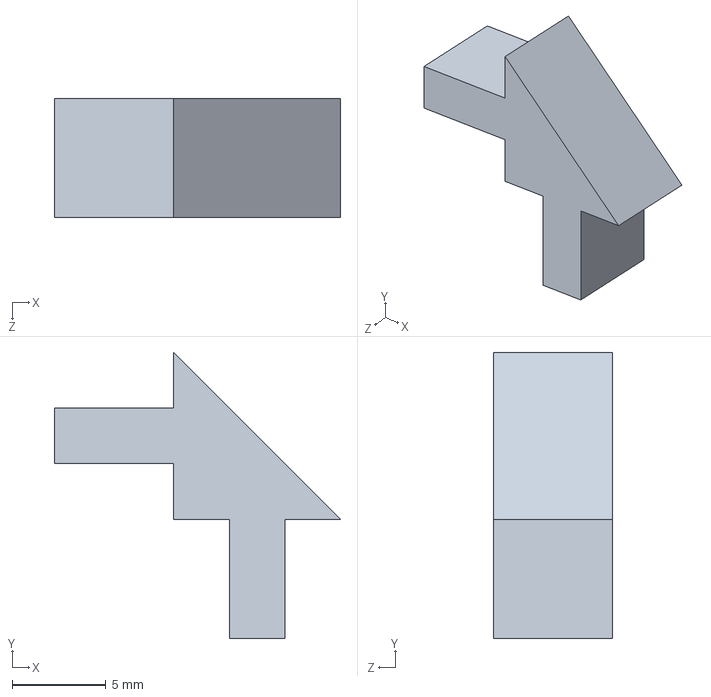
[picture p66: CAD file, 2015-07-29]
CAD/TestBed Alternate/alt_Lbracket_support.SLDPRT
15.2 x 15.2 x 6.35 mm
