drivkin/Autobalance/CAD/TestBed Alternate/alt_tabnslot_bracket.SLDPRT

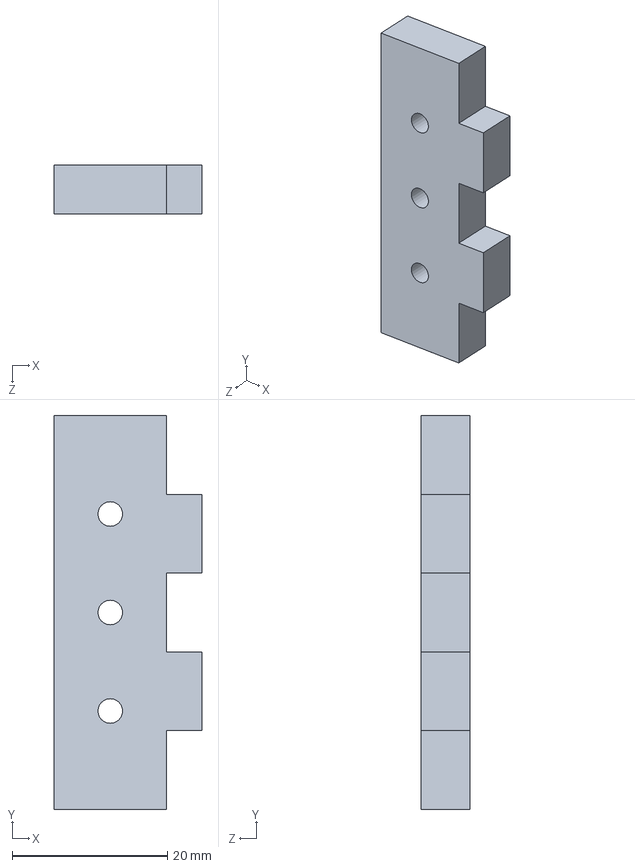
[picture p67: CAD file, 2015-07-29]
CAD/TestBed Alternate/alt_tabnslot_bracket.SLDPRT
19.1 x 50.8 x 6.35 mm
