drivkin/Autobalance/CAD/TestBed Alternate/alt_Lbracket_vert.SLDPRT

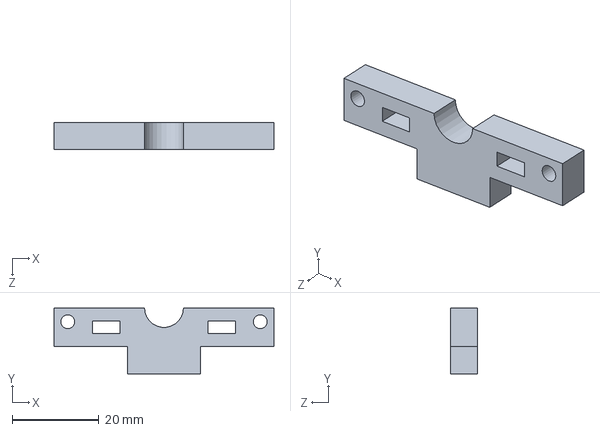
[picture p68: CAD file, 2015-07-29]
CAD/TestBed Alternate/alt_Lbracket_vert.SLDPRT
50.8 x 15.2 x 6.35 mm
