drivkin/Autobalance/CAD/TestBed Alternate/alt_shaft_coupler_zaxis.SLDPRT

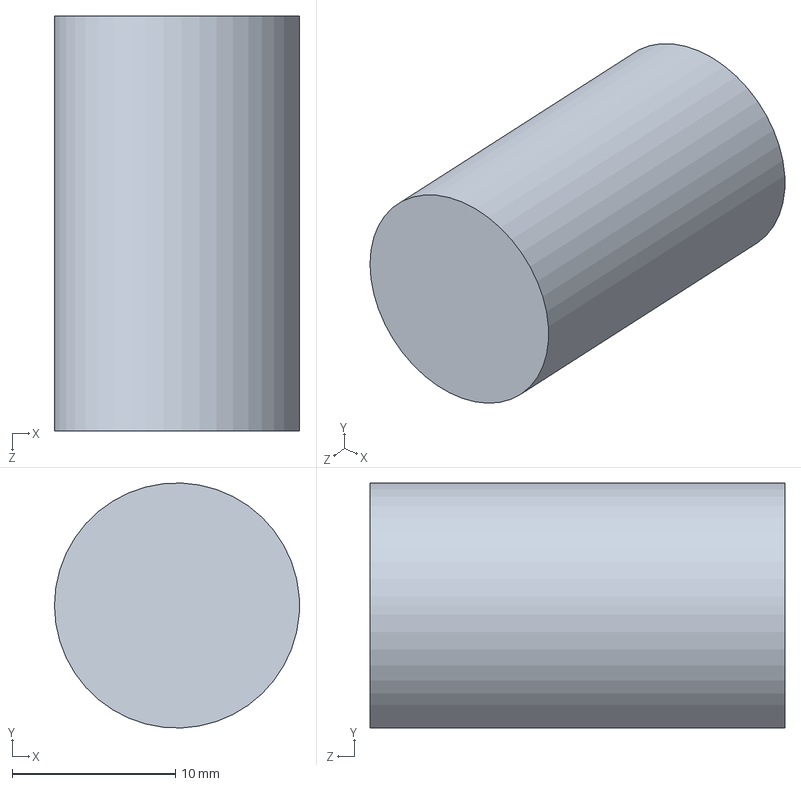
[picture p69: CAD file, 2015-07-17]
CAD/TestBed Alternate/alt_shaft_coupler_zaxis.SLDPRT
15.0 x 15.0 x 25.4 mm
