drivkin/Autobalance/CAD/TestBed Alternate/alt_ABsphere.SLDPRT

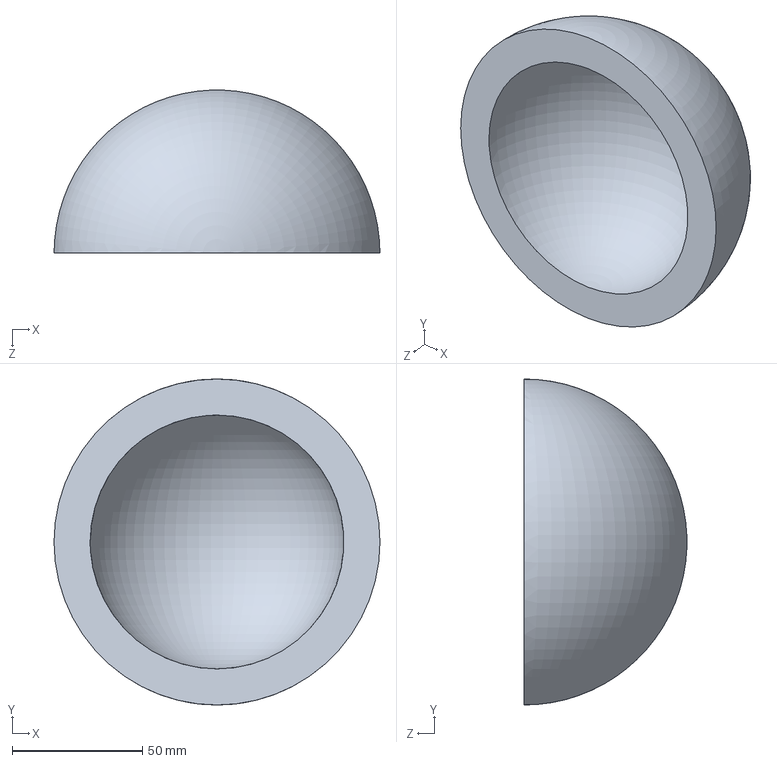
[picture p70: CAD file, 2015-07-17]
CAD/TestBed Alternate/alt_ABsphere.SLDPRT
125.0 x 125.0 x 62.4 mm
