drivkin/Autobalance/CAD/TestBed Alternate/alt_3_16_sleeve_bearing_MM_9440T63.SLDPRT

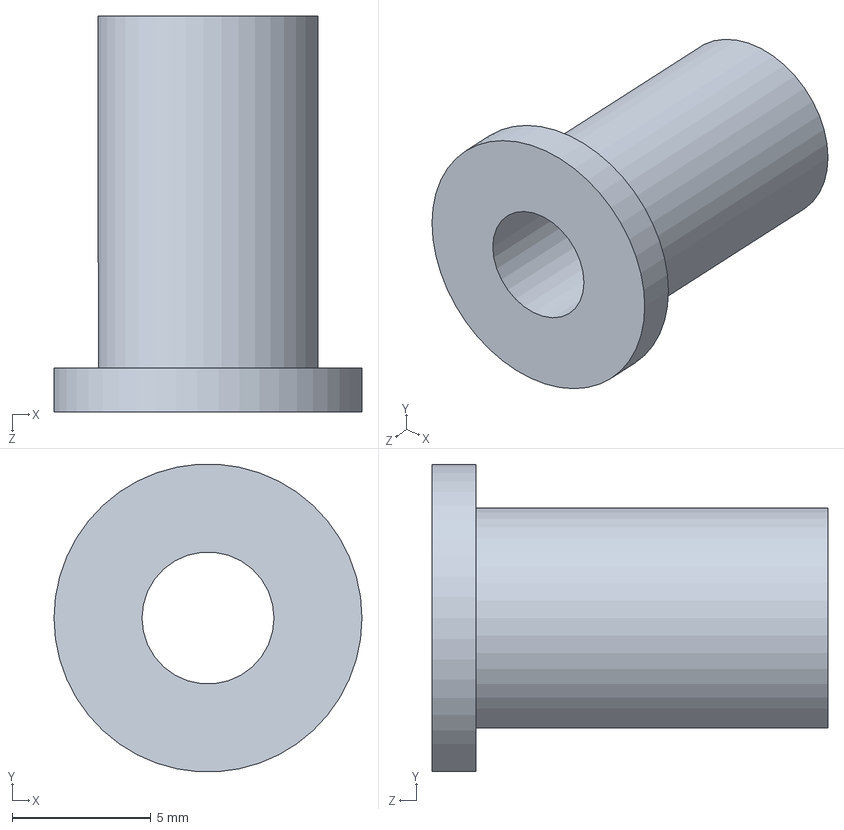
[picture p71: CAD file, 2015-07-17]
CAD/TestBed Alternate/alt_3_16_sleeve_bearing_MM_9440T63.SLDPRT
11.1 x 11.1 x 14.3 mm
