drivkin/Autobalance/CAD/TestBed Alternate/alt_bearing_MM_6383K213_zaxis.SLDPRT

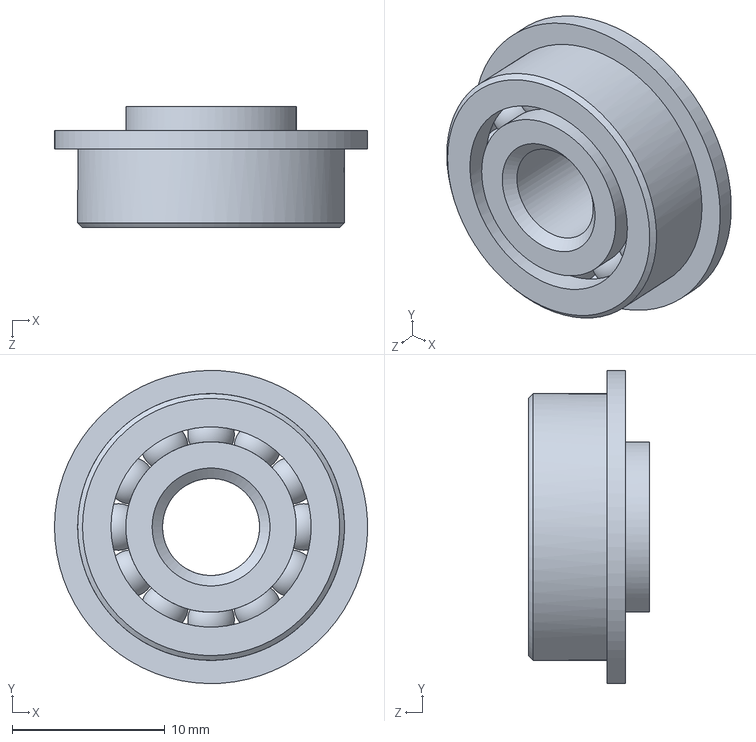
[picture p72: CAD file, 2015-07-17]
CAD/TestBed Alternate/alt_bearing_MM_6383K213_zaxis.SLDPRT
20.5 x 20.5 x 7.94 mm
