drivkin/Autobalance/CAD/TestBed Alternate/alt_supportLS.SLDPRT

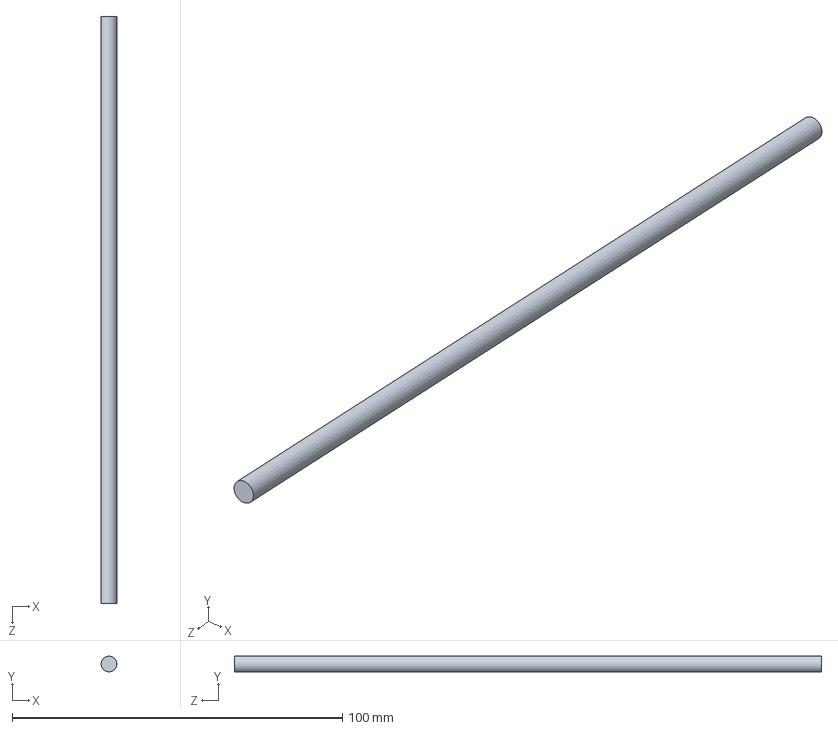
[picture p73: CAD file, 2015-07-17]
CAD/TestBed Alternate/alt_supportLS.SLDPRT
4.76 x 4.76 x 177.8 mm
