drivkin/Autobalance/CAD/TestBed Alternate/alt_verticalSupport.SLDPRT

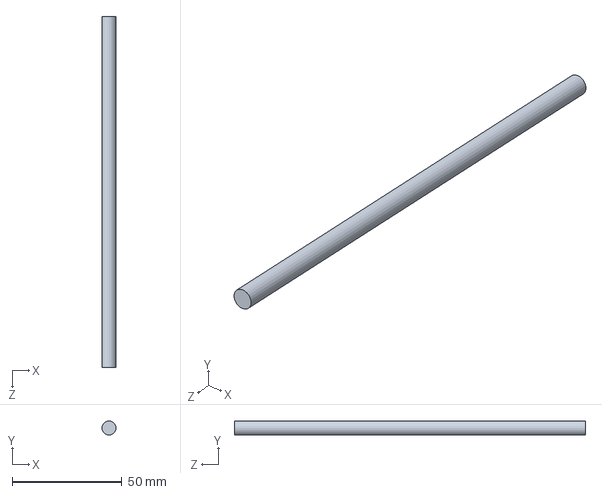
[picture p74: CAD file, 2015-07-17]
CAD/TestBed Alternate/alt_verticalSupport.SLDPRT
6.35 x 6.35 x 159.6 mm
