drivkin/Autobalance/(list of files, cad)

Other CAD files:
CAD/TestBed Alternate/alt_AD_Testbed_Bottom_LEDholes.SLDPRT
CAD/TestBed/sun_sensor_mount.SLDPRT
CAD/TestBed Alternate/alt_LE 3709z mounting option 8.SLDPRT
CAD/TestBed Alternate/alt_bracket.SLDPRT
CAD/TestBed Alternate/alt_third_floor.SLDPRT
CAD/TestBed Alternate/alt_shaft_coupler.SLDPRT
CAD/TestBed Alternate/alt_bearing_MM_6383K213.SLDPRT
CAD/TestBed Alternate/alt_ABpedestal.SLDPRT
CAD/FSR/for_laser.SLDDRW
CAD/FSR/hex_nut.SLDPRT
CAD/FSR/horz_slider_no_screw.SLDPRT
CAD/FSR/horz_slider_screw.SLDPRT
CAD/Laser jobs/july28.SLDDRW
CAD/Laser jobs/july29.SLDDRW
CAD/Laser jobs/sept2 calibrator.SLDDRW
CAD/TestBed Alternate/alt_flagned antibacklash nut.SLDPRT
CAD/TestBed Alternate/alt_flagned antibacklash nut_zaxis.SLDPRT
CAD/TestBed Alternate/alt_lead screw.SLDPRT
CAD/TestBed Alternate/alt_lead screw_zaxis.SLDPRT
CAD/TestBed Alternate/alt_shoulder_screw_MM_91259A154.SLDPRT
CAD/TestBed Alternate/alt_shoulder_screw_MM_91259A154_zaxis.SLDPRT
CAD/TestBed Alternate/laser_cutter_drawing.SLDDRW
CAD/TestBed/Bottom Floor july 7.SLDDRW
CAD/first time mockup/B18.2.3.6M - Heavy hex bolt M12 x 1.75 x 100 --100C.sldprt
CAD/force sensor calibrator/for cutting.SLDDRW
CAD/lead screw assembly/preliminary/LSA.SLDASM
CAD/lead screw assembly/preliminary/baseHorz.SLDPRT
CAD/lead screw assembly/preliminary/endpieceLS.SLDPRT
CAD/lead screw assembly/preliminary/lead screw.SLDPRT
CAD/lead screw assembly/preliminary/shaft_coupler.SLDPRT
CAD/lead screw assembly/preliminary/supportLS.SLDPRT
CAD/lead screw assembly/preliminary/weightLS.SLDPRT
CAD/lead screw assembly/v1/3_16_sleeve_bearing_MM_9440T63.SLDPRT
CAD/lead screw assembly/v1/LE 3709z mounting option 8.SLDPRT
CAD/lead screw assembly/v1/LSA.SLDASM
CAD/lead screw assembly/v1/baseHorz.SLDPRT
CAD/lead screw assembly/v1/bearing_MM_6383K213.SLDPRT
CAD/lead screw assembly/v1/endpieceLS.SLDPRT
CAD/lead screw assembly/v1/flagned antibacklash nut.SLDPRT
CAD/lead screw assembly/v1/lead screw.SLDPRT
CAD/lead screw assembly/v1/shaft_coupler.SLDPRT
CAD/lead screw assembly/v1/shoulder_screw_MM_91259A154.SLDPRT
CAD/lead screw assembly/v1/sleeve_bearing_MM_944T17.SLDPRT
CAD/lead screw assembly/v1/supportLS.SLDPRT
CAD/lead screw assembly/v1/weightLS.SLDPRT
CAD/lead screw assembly/v1_zaxis_mod/LE 3709z mounting option 8_zaxis.SLDPRT
CAD/lead screw assembly/v1_zaxis_mod/LSA_zaxis.SLDASM
CAD/lead screw assembly/v1_zaxis_mod/Preliminary Drawing for Estimate.SLDDRW
CAD/lead screw assembly/v1_zaxis_mod/baseHorz_zaxis.SLDPRT
CAD/lead screw assembly/v1_zaxis_mod/bearing_MM_6383K213_zaxis.SLDPRT
CAD/lead screw assembly/v1_zaxis_mod/endpiece.SLDPRT
CAD/lead screw assembly/v1_zaxis_mod/endpieceLS_zaxis.SLDPRT
CAD/lead screw assembly/v1_zaxis_mod/flagned antibacklash nut_zaxis.SLDPRT
CAD/lead screw assembly/v1_zaxis_mod/lead screw_zaxis.SLDPRT
CAD/lead screw assembly/v1_zaxis_mod/shaft_coupler_zaxis.SLDPRT
CAD/lead screw assembly/v1_zaxis_mod/shoulder_screw_MM_91259A154_zaxis.SLDPRT
CAD/lead screw assembly/v1_zaxis_mod/supportLS_zaxis.SLDPRT
CAD/lead screw assembly/v1_zaxis_mod/weightLS_zaxis.SLDPRT
