drivkin/Autobalance/presentations/force sensor amplifier schematic.pdf

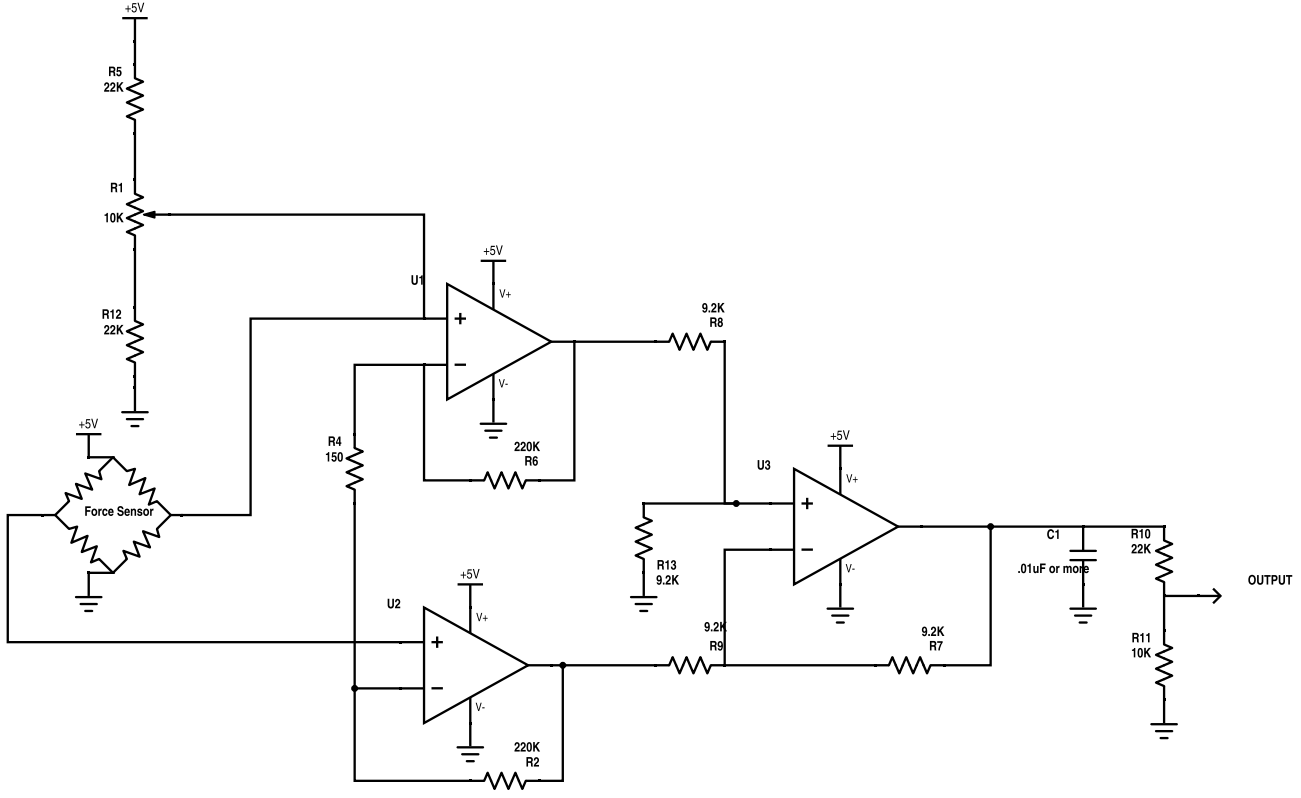
[picture p75: page 1]
