drivkin/Autobalance/(commit log)

2015-06-18 References and Hardware links
    Added a bunch of references (mostly from Qi Gong's paper) and some links
    to possible hardware. Also the beginnings of a powerpoint for the matts
2015-06-18 Preliminary CAD model
    Made a solidworks model to present to the Matts the general layout, no
    real components
    [B18.2.2.4M - Hex flange nut, M12 x 1.75 --N.SLDPRT, B18.2.3.6M - Heavy hex bolt M12 x 1.75 x 100 --100C.sldprt, BIGweight.SLDPRT, actuator_assembly.SLDASM, balance_base.SLDPRT, bearing.SLDPRT, manual_balance_assembly.SLDASM, manual_balance_rim.SLDPRT]
2015-06-24 EKF written
    Wrote an EKF and simulator to test it. It seems to work alright, but I
    haven't added noise yet.
    [whole_assembly.SLDASM]
2015-06-24 N-422 linear stage
    Preliminary design of a linear stage using the PI N-422 piezomotor
    [B18.6.7M - M2 x 0.4 x 20 Indented HHMS --20C.sldprt, N-422_50.SLDPRT, actuator_assembly.SLDASM, base.SLDPRT, driver.SLDPRT, endPiece.SLDPRT, linear weight stage.SLDASM, supportRod.SLDPRT]
2015-07-02 discrete EKF, Smoother, Order
    Wrote a discrete EKF, which works, a smoother which explodes near t = 0,
    and compiled an excel spreadsheet with the first order we need to get
    cracking on the first autobalancer
    [first order.xlsx]
2015-07-06 Preliminary lead screw assembly, side by side
    Did preliminary lead screw assembly just to get a feel for it and to get
    a quote from the machinist, also made a side by side comparison of lead
    screw vs piezo electric actuators. Attempting to merge branches
    [LSA.SLDASM, Preliminary Drawing for Estimate.SLDDRW, baseHorz.SLDPRT, endpiece.SLDPRT, endpieceLS.SLDPRT, lead screw.SLDPRT, linear weight stage.SLDASM, shaft_coupler.SLDPRT]
2015-07-06 comparison and presentation update
    Updated comparison of lead screw and piezo approach, and updated the
    presentation to include the lead screw approach
    [PR_HelixLinear.xlsx, first order.xlsx]
2015-07-06 Refining lead screw assembly
    Making a more realistic lead screw assembly that I can actually use for
    machining. Had to make the stepper motor model myself. Also, this stuff
    is now in solidworks 2014
    [Bottom Floor july 7.SLDDRW, LE 3709z mounting option 8.SLDPRT, LSA.SLDASM, Preliminary Drawing for Estimate.SLDDRW, baseHorz.SLDPRT, endpiece.SLDPRT, endpieceLS.SLDPRT, lead screw.SLDPRT]
2015-07-09 Simulation, Control, CAD, Orders, New Laptop
    Main achievement is development of an accurate simulator for the body +
    3 linear mass system which takes into account the linear velocity and
    acceleration of the masses. Also tested a proportional controller for
    the first balancing stage by looking at euler angle errors. Works well
    if you can start it at the equilibrium position, and may require several
    resets.
    Refined the CAD model somewhat to include anti-backlash nut.
    Refined the helix linear order a little because there was some trouble
    getting it through
    First commit from new laptop (Cindy2)
    [Bottom Floor july 7.SLDDRW, LSA.SLDASM, PR_HelixLinear.xlsx, PR_Lin_Eng.xlsx, baseHorz.SLDPRT, endpieceLS.SLDPRT, flagned antibacklash nut.SLDPRT, supportLS.SLDPRT]
2015-07-11 Improved filter
    Wrote an improved Kalman filter which doesn't go unstable when coupled
    with control. It does theoretically include most of the dynamics of the
    simulator, but it takes too damn long to compute all their derivatives
    so it runs super slow. I then dropped most of the terms and just kept
    the gravity due to the sliding masses (in the linearized phi matrix. The
    x propagation uses the full dynamics). Need to experiment more with the
    filter. Proportional control about the estimate works ok, but the
    problem is that the estimated CoG goes to zero before the real CoG,
    which is something that needs to be dealt with.
2015-07-14 Estimation and control work
    Messed around with making a better EKF that included sliding mass
    dynamics and doing control using that, but it didn't work too well (the
    CoM estimate seemed to just go to zero even without control). Also
    experimented with a square proportional feedback law for the basic
    balancing algortihm
    [McMasterJuly13.xlsx, PR_McMaster.xlsx]
2015-07-15 Testbed assembly with actuators
    Did most of the design for a testbed with actuators. Have not inserted
    any mounting holes yet. Still need to add limit switches and refine the
    z axis mounting
    [AD_Testbed_Bottom_LEDholes.SLDPRT, AD_Testbed_Top.SLDPRT, LE 3709z mounting option 8_zaxis.SLDPRT, LSA.SLDASM, LSA_zaxis.SLDASM, Preliminary Drawing for Estimate.SLDDRW, baseHorz.SLDPRT, baseHorz_zaxis.SLDPRT]
2015-07-16 Almost finished testbed CAD, doing alternate
    More or less done with the actuator assemblies, and made an assembly
    with the sliding masses, with the z-axis smack-dab in the middle. I want
    to make an alternate one where the z-axis is on the side. Committing now
    because saving a bunch of copies might mess up my SW references.
    [3_16_sleeve_bearing_MM_9440T63.SLDPRT, AD_Testbed_Bottom_LEDholes.SLDPRT, AD_Testbed_Top.SLDPRT, LSA.SLDASM, LSA_zaxis.SLDASM, PR_McMaster.xlsx, baseHorz.SLDPRT, baseHorz_zaxis.SLDPRT]
2015-07-17 Finished Testbed
    Finished the alternate testbed, kind of. Limit switches and driver
    boards are not included. Sent to Matts and Dayne for approval.
    [ABpedestal.SLDPRT, ABsphere.SLDPRT, AD_Testbed_Bottom_LEDholes.SLDPRT, TBSM.SLDASM, alt_3_16_sleeve_bearing_MM_9440T63.SLDPRT, alt_ABpedestal.SLDPRT, alt_ABsphere.SLDPRT, alt_AD_Testbed_Bottom_LEDholes.SLDPRT]
2015-07-29 Refined actuator design
    The l-bracket model was wrong and the real ones were too big so I
    scrapped it for an all acrylic version. Also refined the model of the
    lead nut.
    [McMasterJuly13.xlsx, alt_AD_Testbed_Bottom_LEDholes.SLDPRT, alt_LE 3709z mounting option 8.SLDPRT, alt_LE 3709z mounting option 8_zaxis.SLDPRT, alt_LSA.SLDASM, alt_LSA_zaxis.SLDASM, alt_Lbracket_assembly.SLDASM, alt_Lbracket_horz.SLDPRT]
2015-08-19 Made model of brass weight to attach to the acrylic
    That's it
    [alt_heavyweight.SLDPRT]
2015-08-26 Finished testbed assembly
    ready to laser cut for first time
    [alt_AD_Testbed_Bottom_LEDholes.SLDPRT, alt_AD_Testbed_Top.SLDPRT, alt_LSA.SLDASM, alt_baseHorz.SLDPRT, alt_basement.SLDPRT, alt_endpieceLS.SLDPRT, alt_mini_breadboard.SLDPRT, alt_weightLS.SLDPRT]
2015-08-27 Some Matlab stuff
    Plus McMaster order
    [PR_McMaster_Autobalancer_DR.xlsx]
2015-09-15 Restraint Rig, some changes to testbed basement
    Made a restraint rig, and some changes to the testbed basement. Not much
    else to say.
    [alt_AD_Testbed_Bottom_LEDholes.SLDPRT, alt_AD_Testbed_Top.SLDPRT, alt_TBSM.SLDASM, alt_basement.SLDPRT, alt_food_crate_storage.SLDPRT, alt_vert_spacer_female.SLDPRT, alt_vert_spacer_male.SLDPRT, arm.SLDPRT]
